reinauer/amiga_replacement_project/amiga/Commodore_A1000_Mainboard.gif

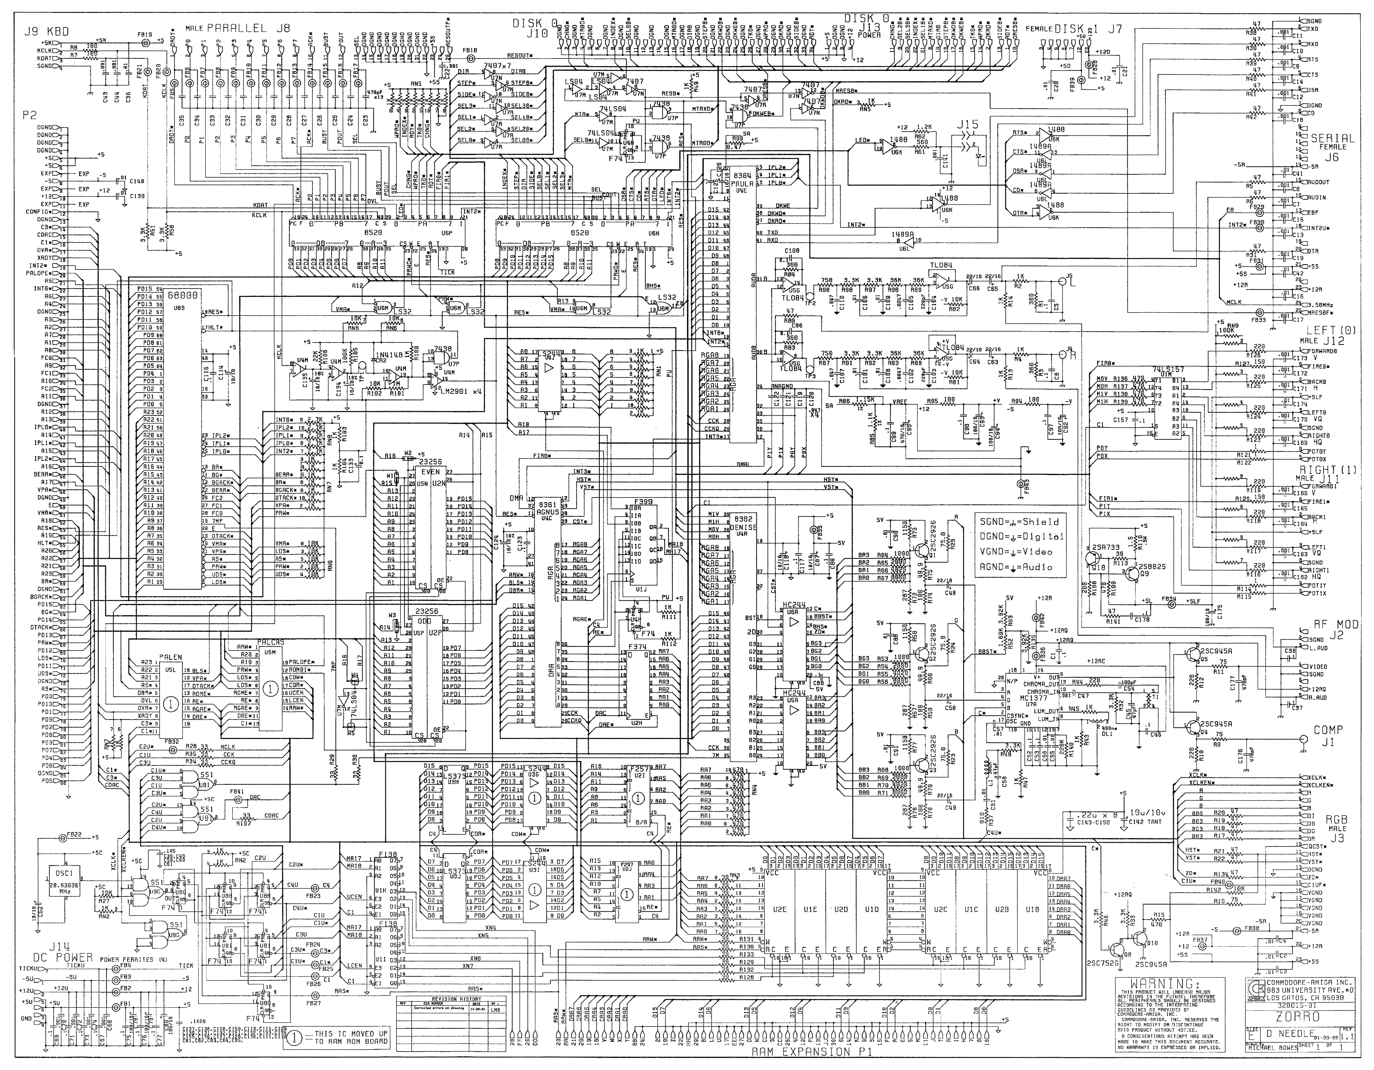
amiga/Commodore_A1000_Mainboard.gif
