reinauer/amiga_replacement_project/amiga/Commodore_A1000_RAM_ROM.gif

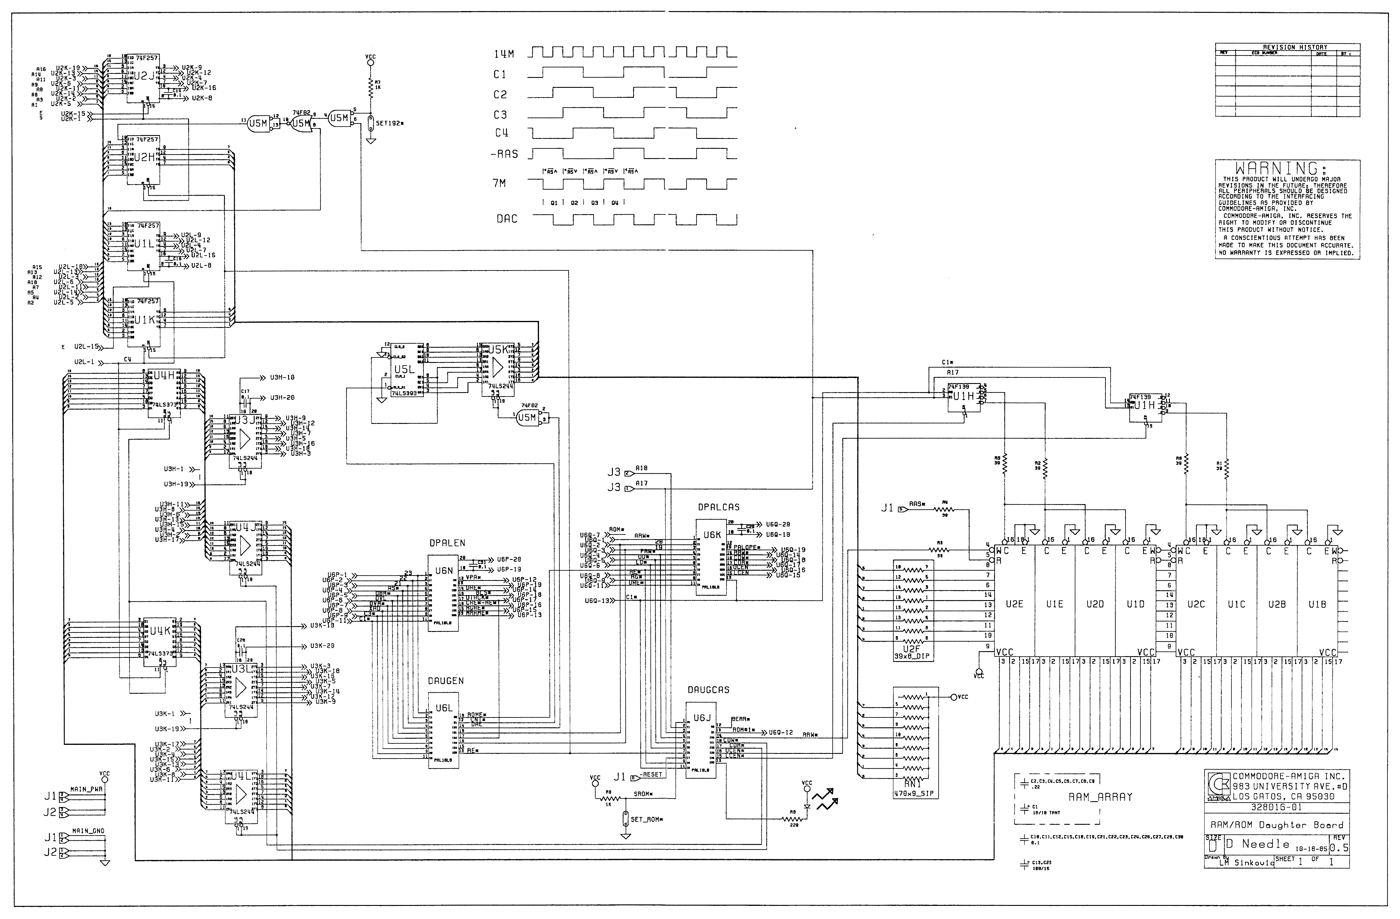
amiga/Commodore_A1000_RAM_ROM.gif
