reinauer/amiga_replacement_project/cia/MOS_8520r4_cia_schematic.png

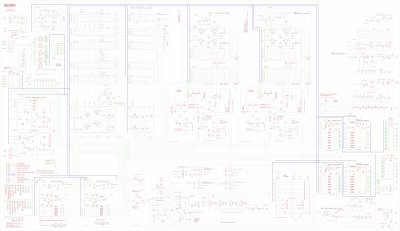
cia/MOS_8520r4_cia_schematic.png
