reinauer/amiga_replacement_project/denise/refs/bpl_shifters.jpg

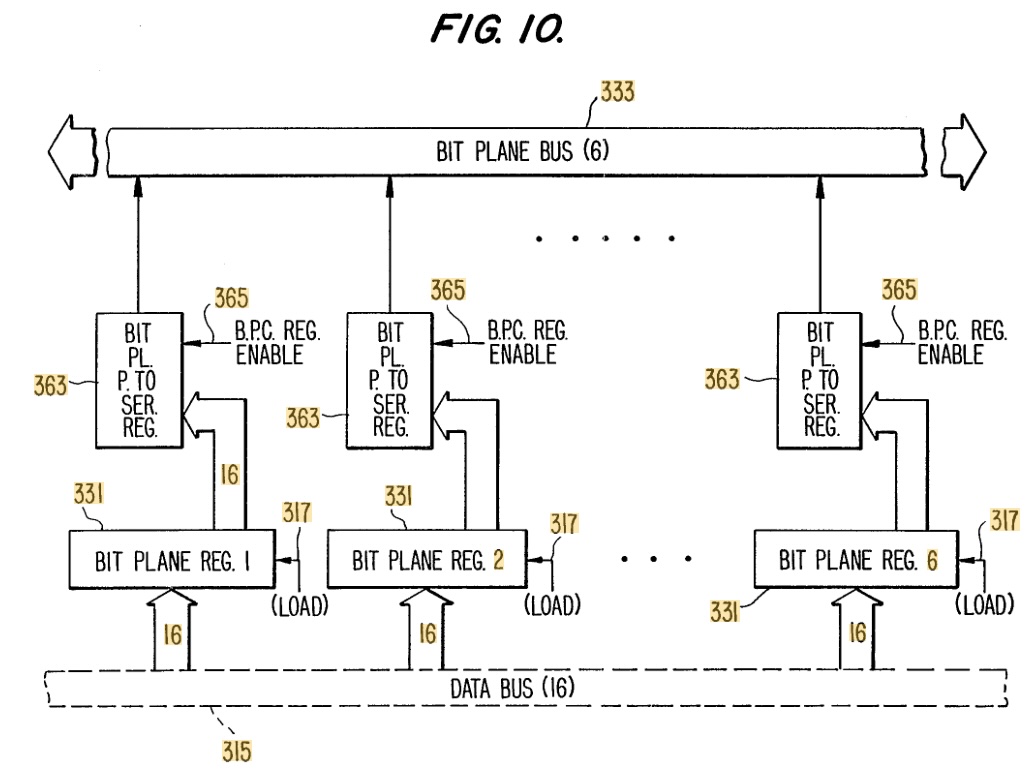
denise/refs/bpl_shifters.jpg
