reinauer/amiga_replacement_project/denise/refs/denise_block.png

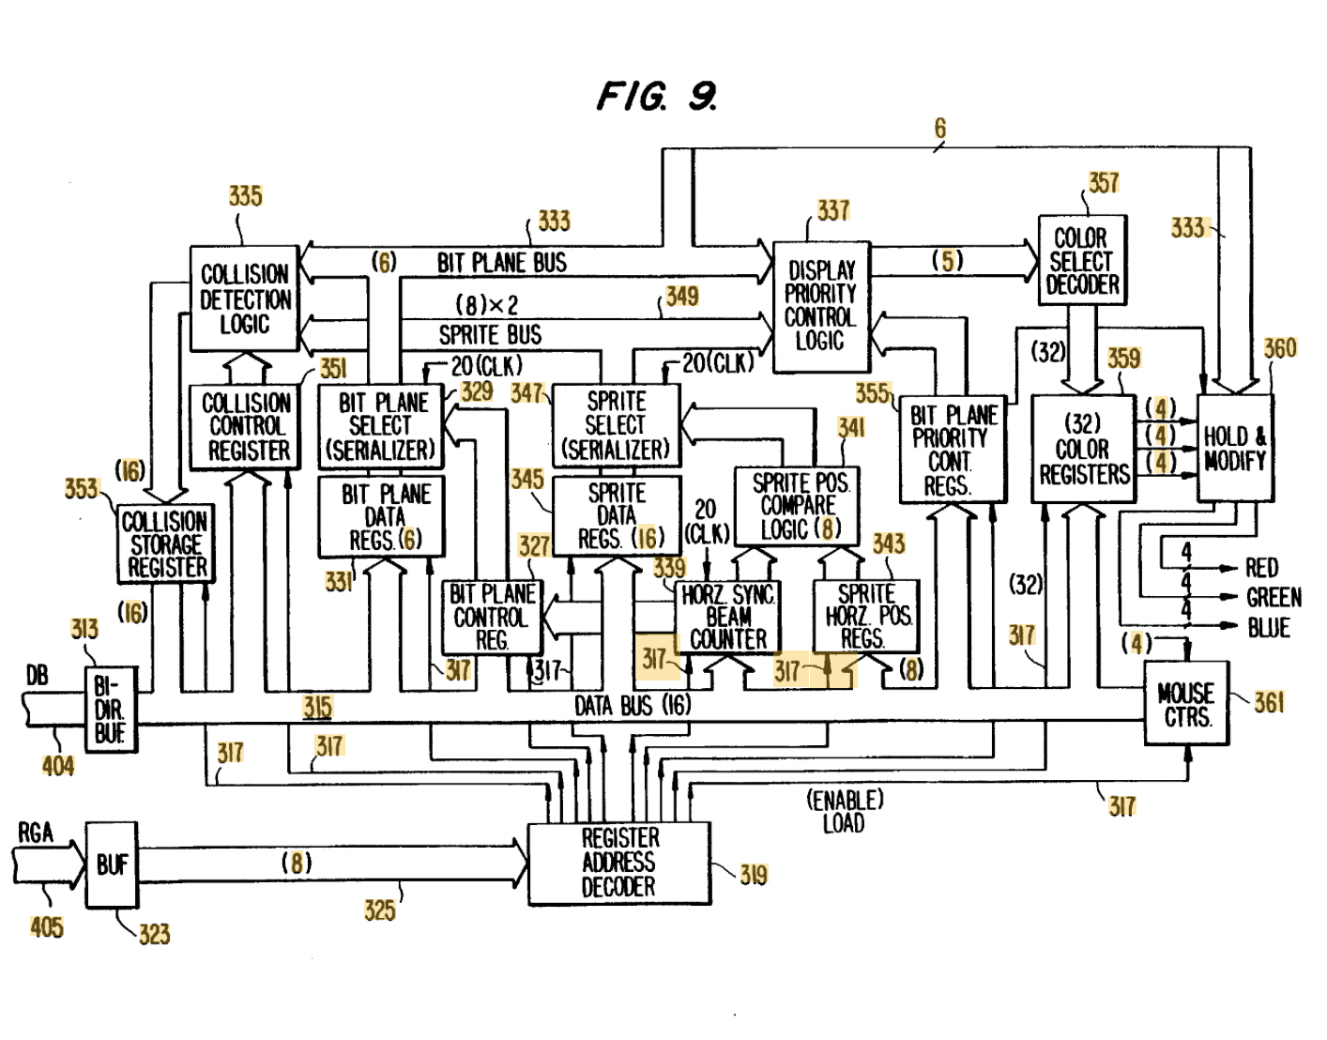
denise/refs/denise_block.png
