reinauer/amiga_replacement_project/denise/refs/spr_shifters.jpg

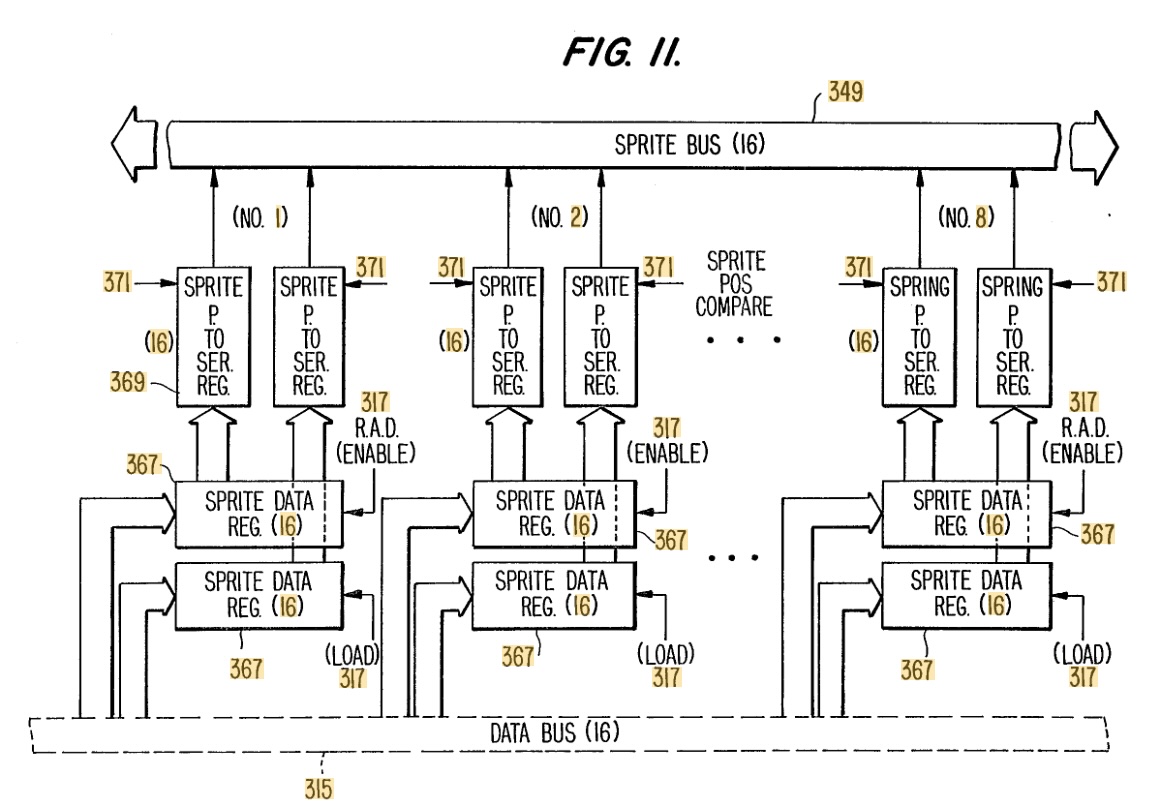
denise/refs/spr_shifters.jpg
