reinauer/amiga_replacement_project/gary/CSG_5719r4_gary_schematic.png

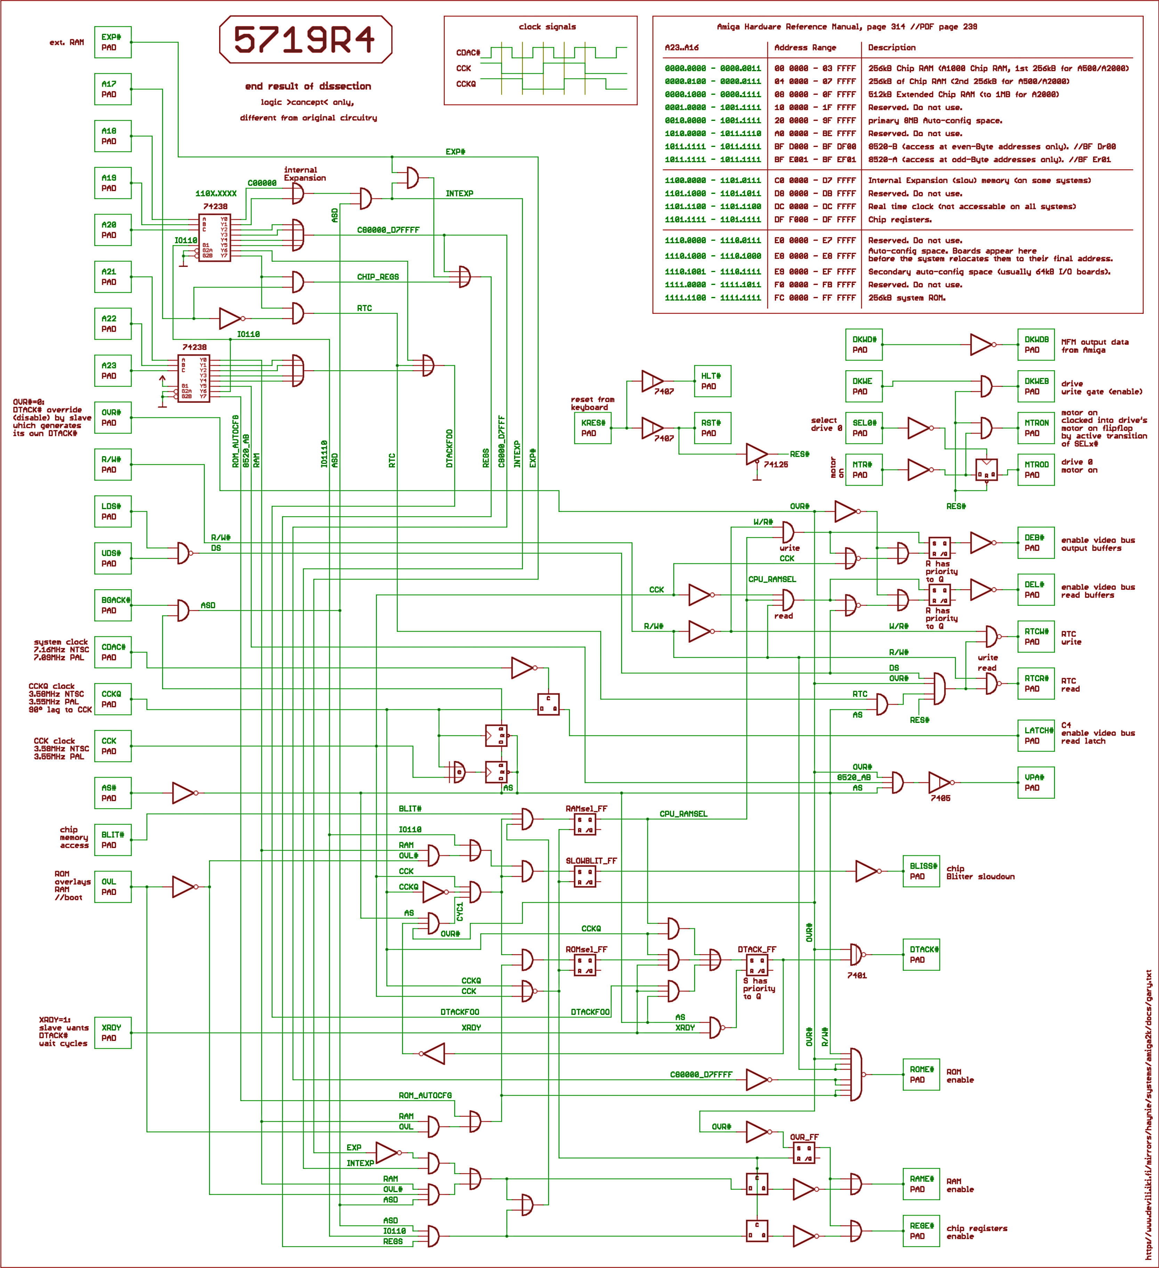
gary/CSG_5719r4_gary_schematic.png
