reinauer/amiga_replacement_project/amiga40dip/AmigaDIP40s.pdf

### BANK0

5V

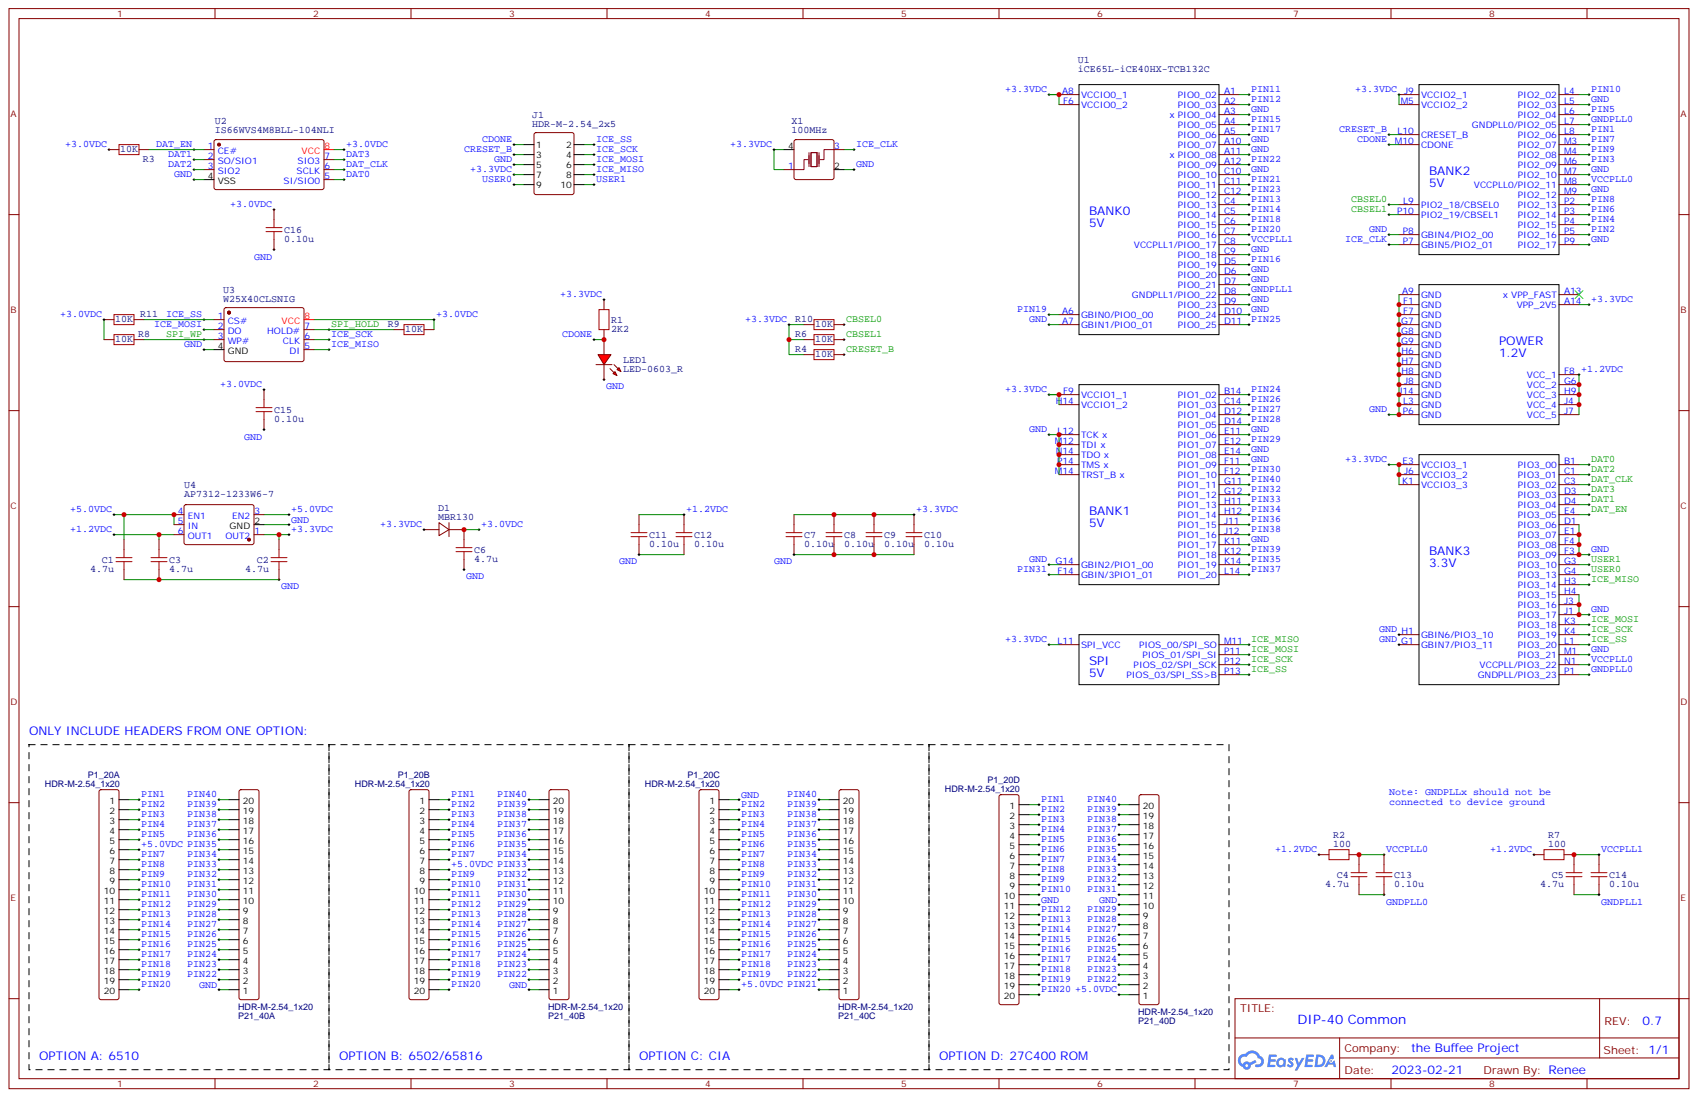
[picture p8: page 1]

ONLY INCLUDE HEADERS FROM ONE OPTION:

Note: GNDPLLx should not be
connected to device ground

Company: the Buffee Project
