reinauer/amiga_replacement_project/amiga48dip/AmigaDIP48s.pdf

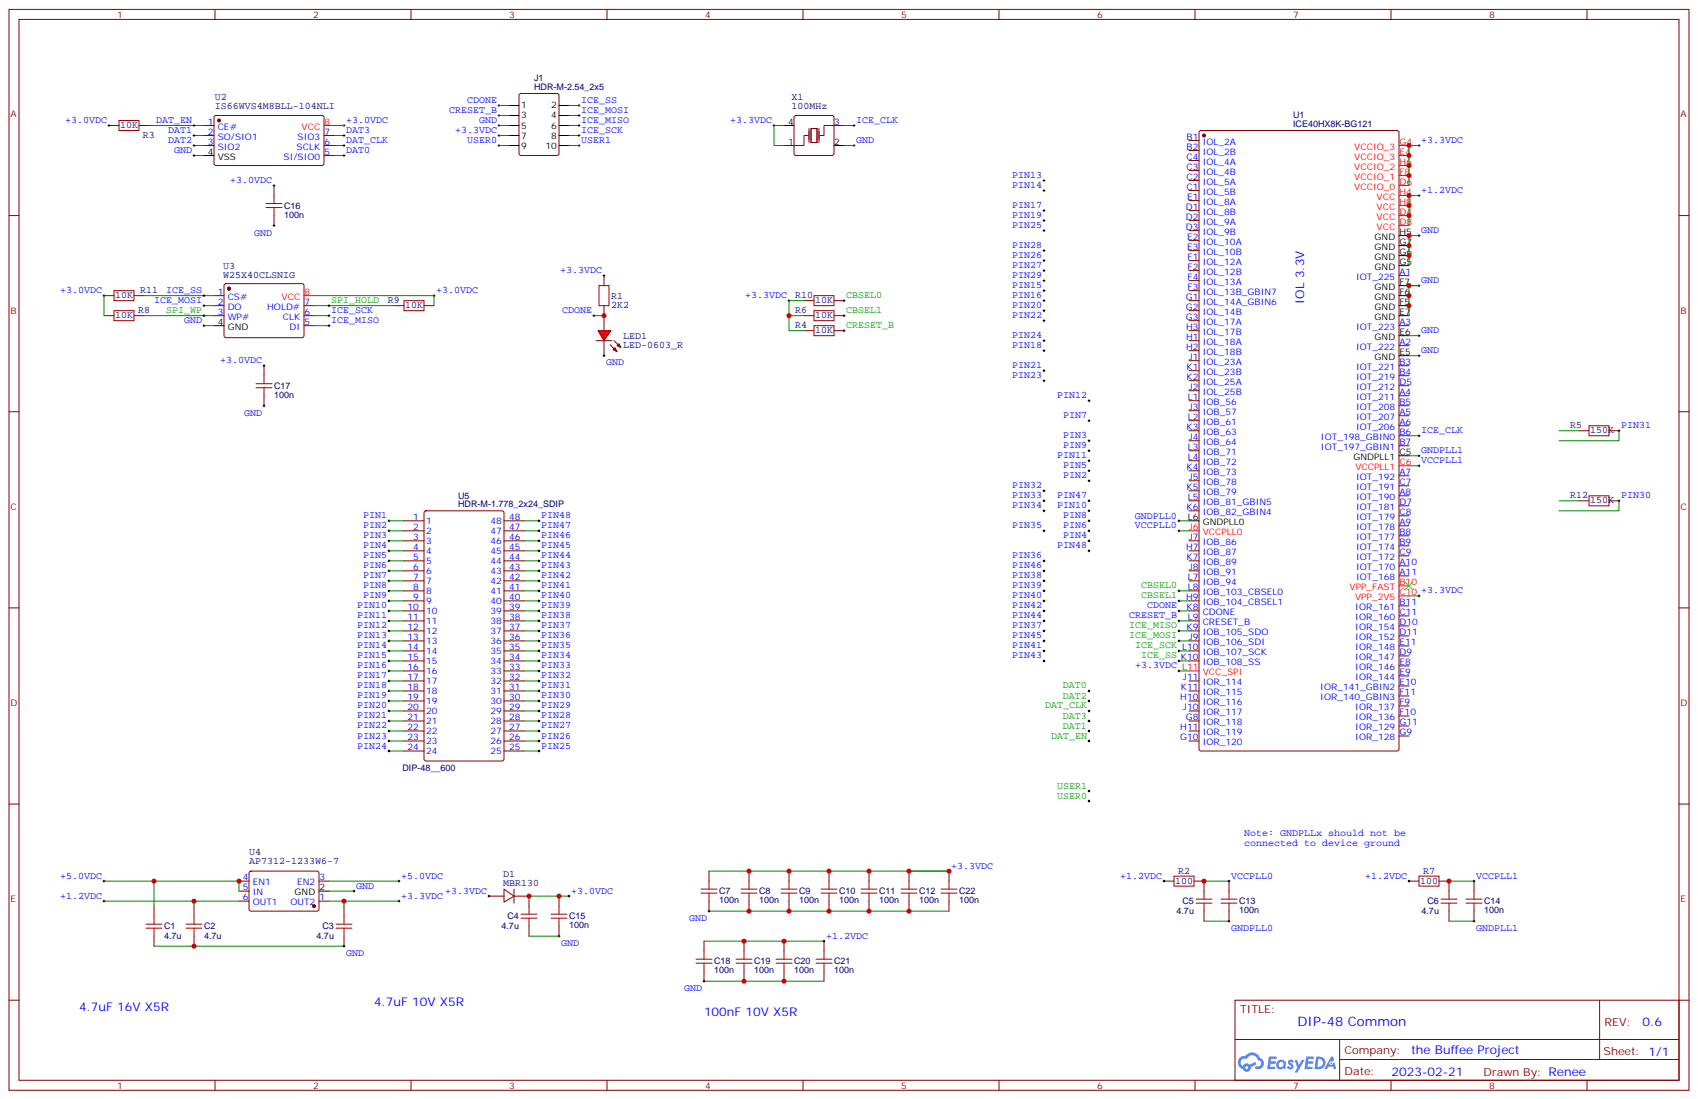
[picture p9: page 1]

Note: GNDPLLx should not be
connected to device ground

Company: the Buffee Project
