reinauer/amiga_replacement_project/gary/Schematic_Gary-Repalcement.sch_2025-07-20.pdf

A | A

1

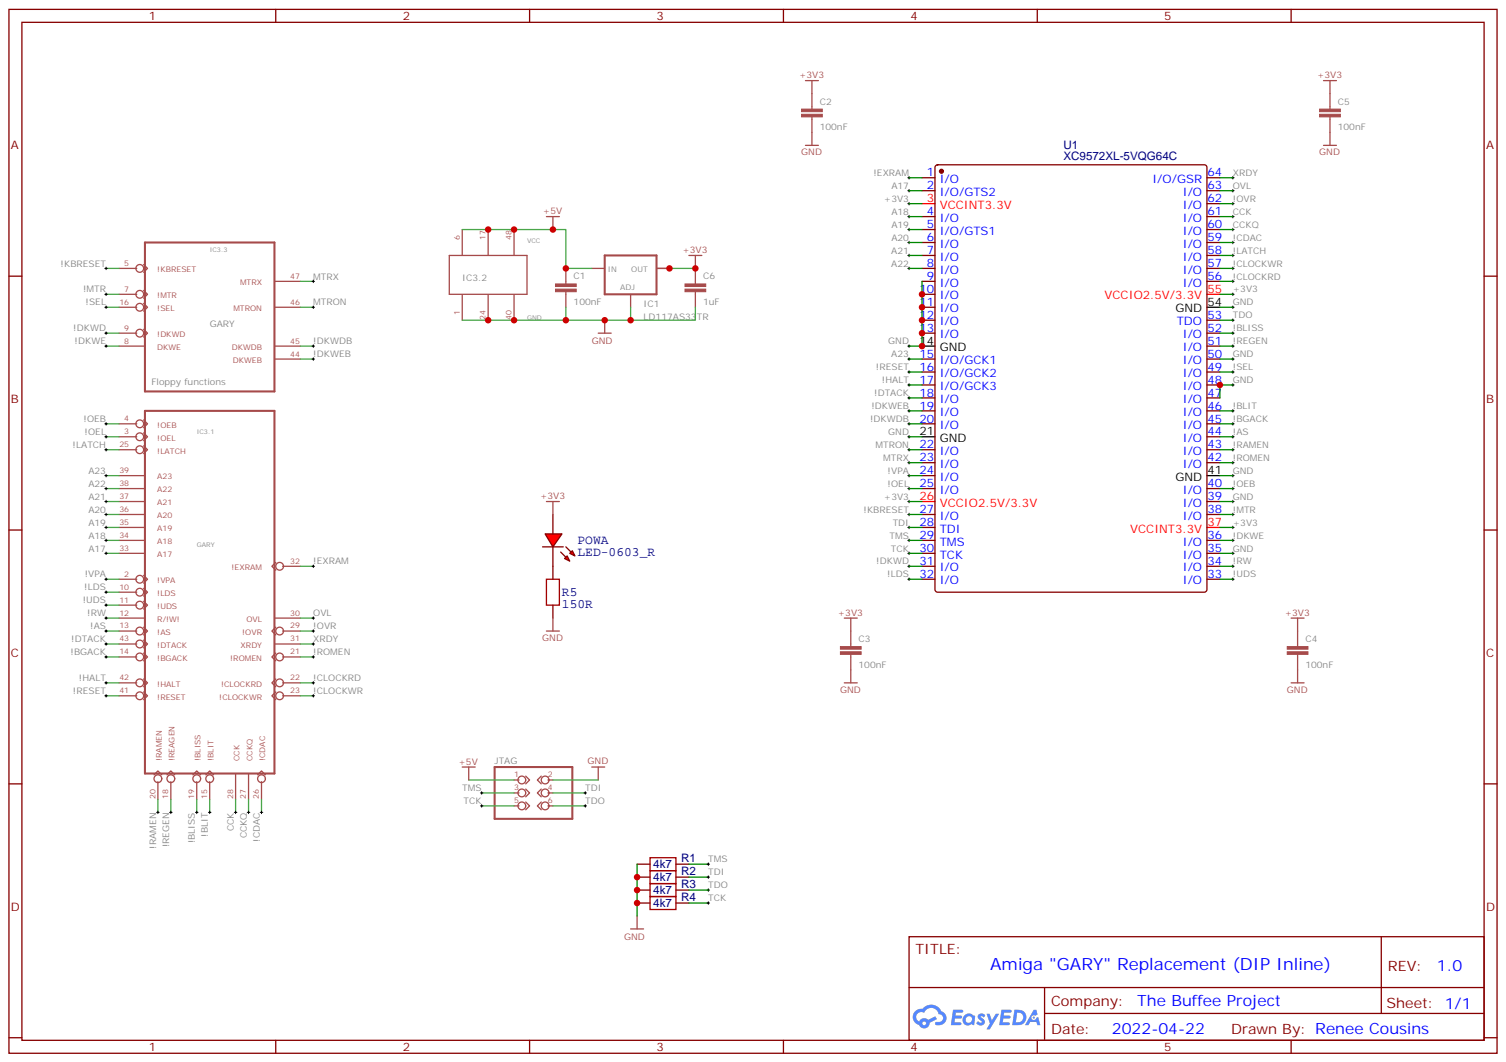
[picture p10: page 1]

Company: The Buffee Project

Drawn By: Renee Cousins
