reinauer/amiga_replacement_project/amber/amber-design-rev6-1.pdf

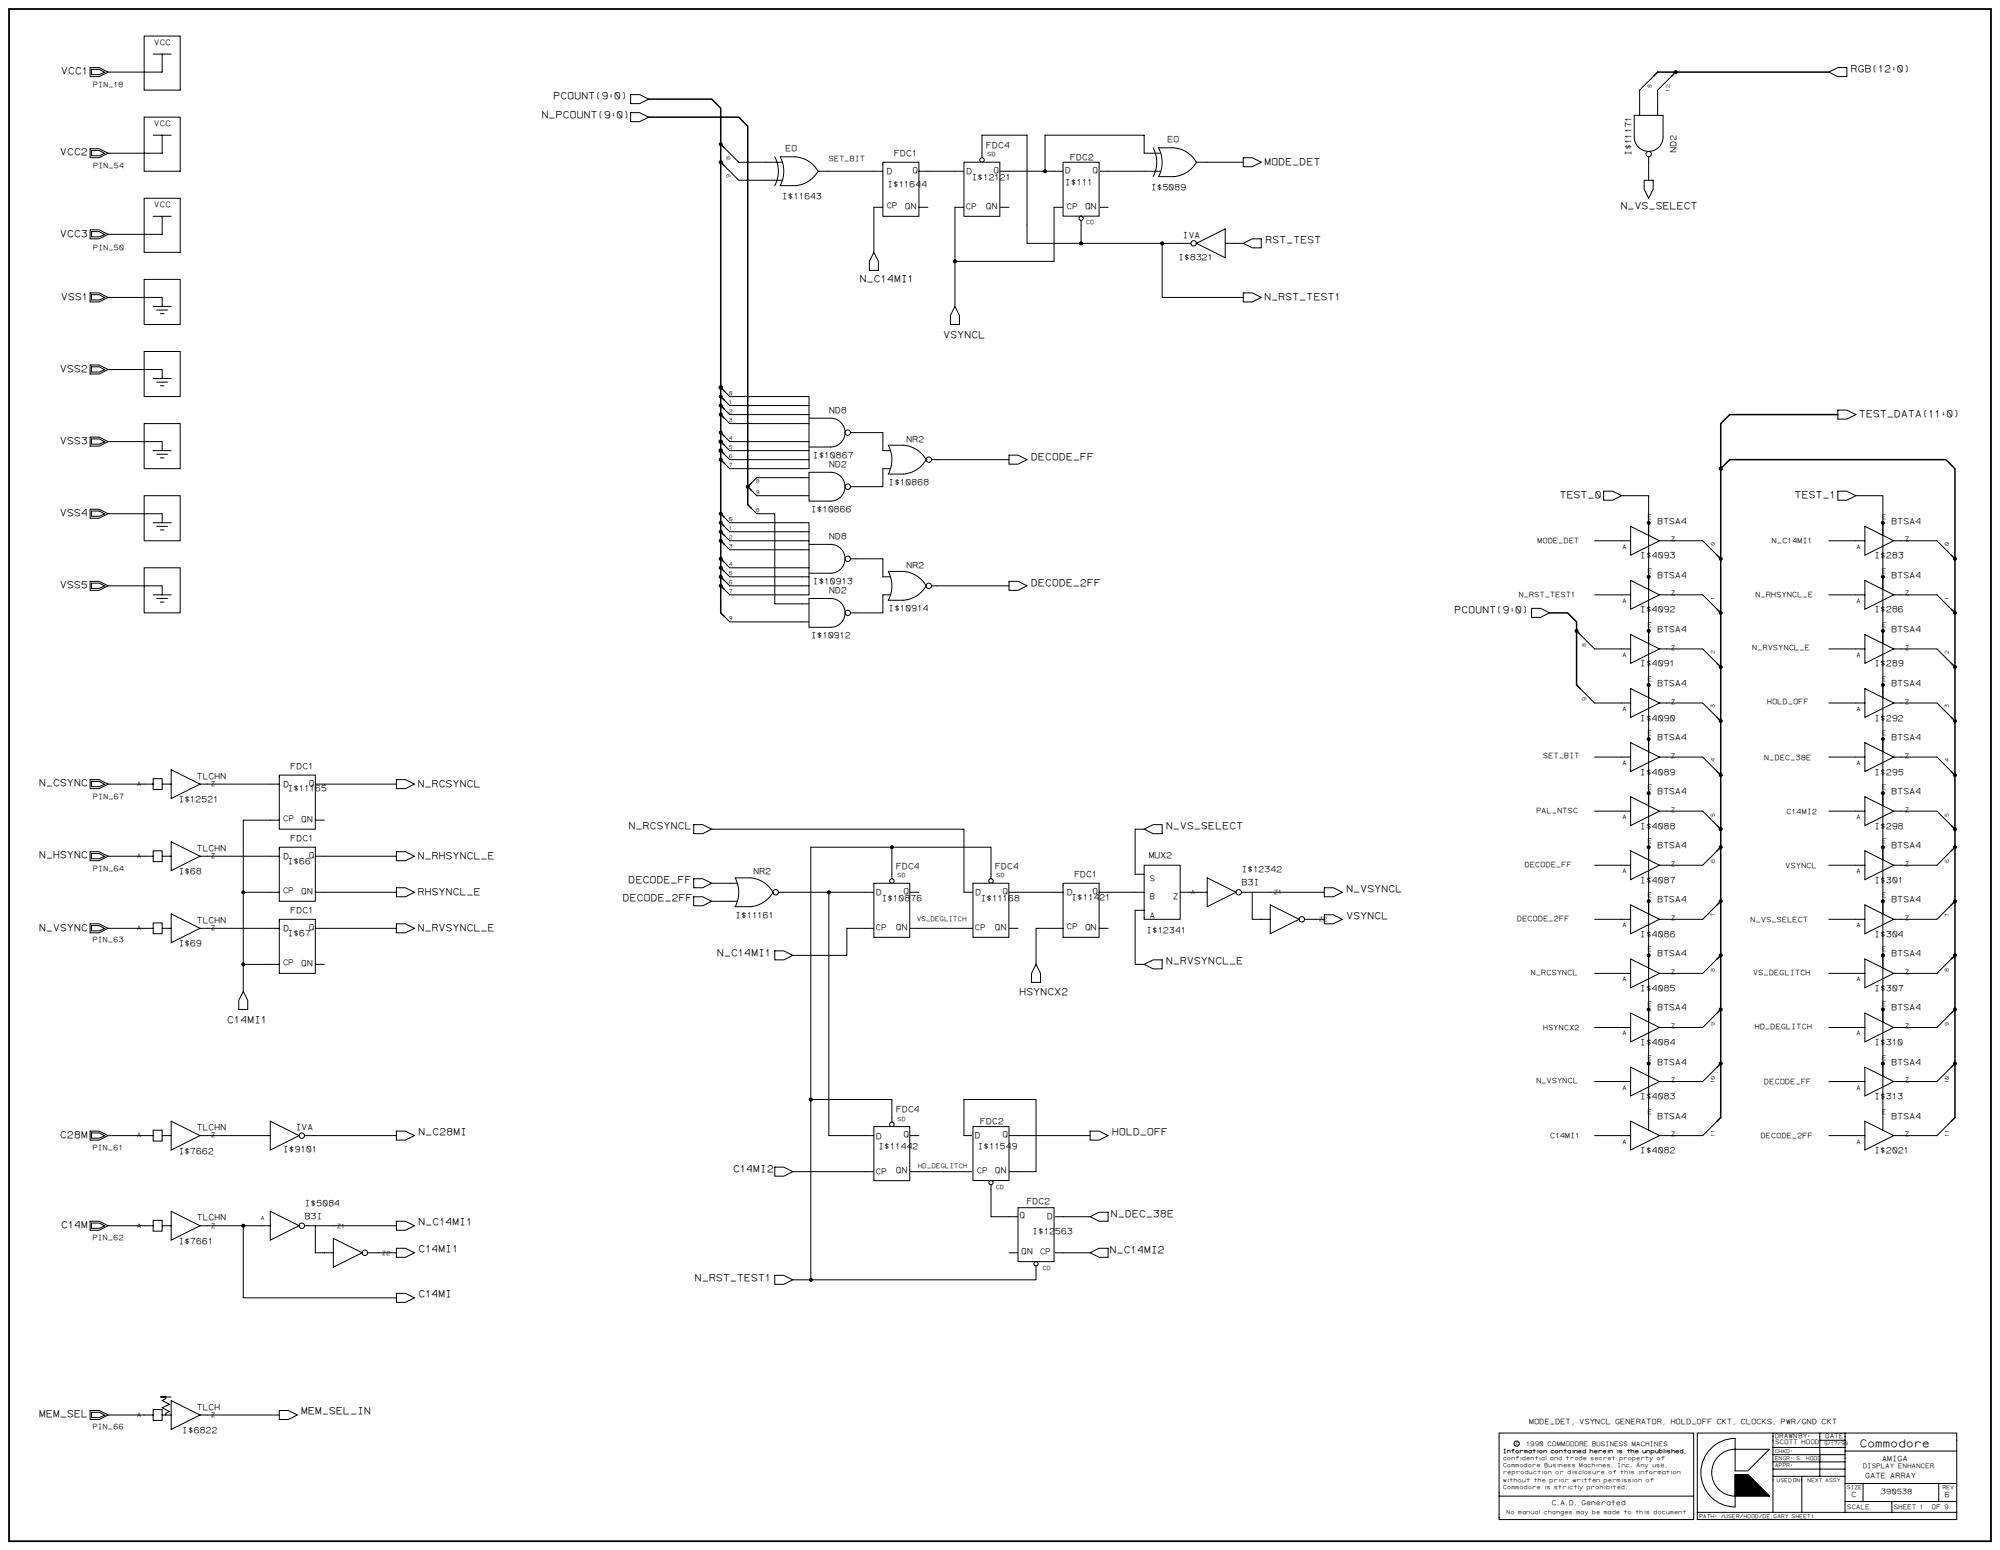
[picture p11: page 1]
N_VSYNC; PIN_63; N_HSYNC; PIN_64; TEST_0; PCOUNT(9:0); VSYNCL; RST_TEST; N_DEC_38E; MODE_DET; MEM_SEL; PIN_66; N_VS_SELECT; VS_DEGLITCH; HD_DEGLITCH; DECODE_FF; VSS2; DECODE_2FF; VSS4; PIN_62; VSS3; VSS5; TEST_DATA(11:0); N_RST_TEST1; MEM_SEL_IN; PIN_61; TEST_1; N_RCSYNCL; N_RVSYNCL_E; N_RHSYNCL_E; N_PCOUNT(9:0); SET_BIT; PAL_NTSC; PIN_67; N_CSYNC; N_VSYNCL; HSYNCX2; RGB(12:0); RHSYNCL_E; VCC3; PIN_50; HD_DEGLITCH C14MI2; VCC2; PIN_54; VSS1; VCC1; PIN_18; HOLD_OFF; Commodore; DRAWN BY:; DATE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

MODE_DET, VSYNCL GENERATOR, HOLD_OFF CKT, CLOCKS, PWR/GND CKT

1990 COMMODORE BUSINESS MACHINES

Information Information contained contained herein is the unpublished, unpublished,
confidential and trade secret property of
Commodore Business Machines, Inc. Any use,
reproduction or disclosure of this information
without the prior written permission of
Commodore is strictly prohibited.

CHKD:
ENGR: S. HOOD
APPR:

USED ON | NEXT ASSY

SIZE C 6 | 390538 | REV

SCALE | SHEET 1 OF 9

No manual changes may be made to this document

PATH: /USER/HOOD/DE.GARY SHEET1

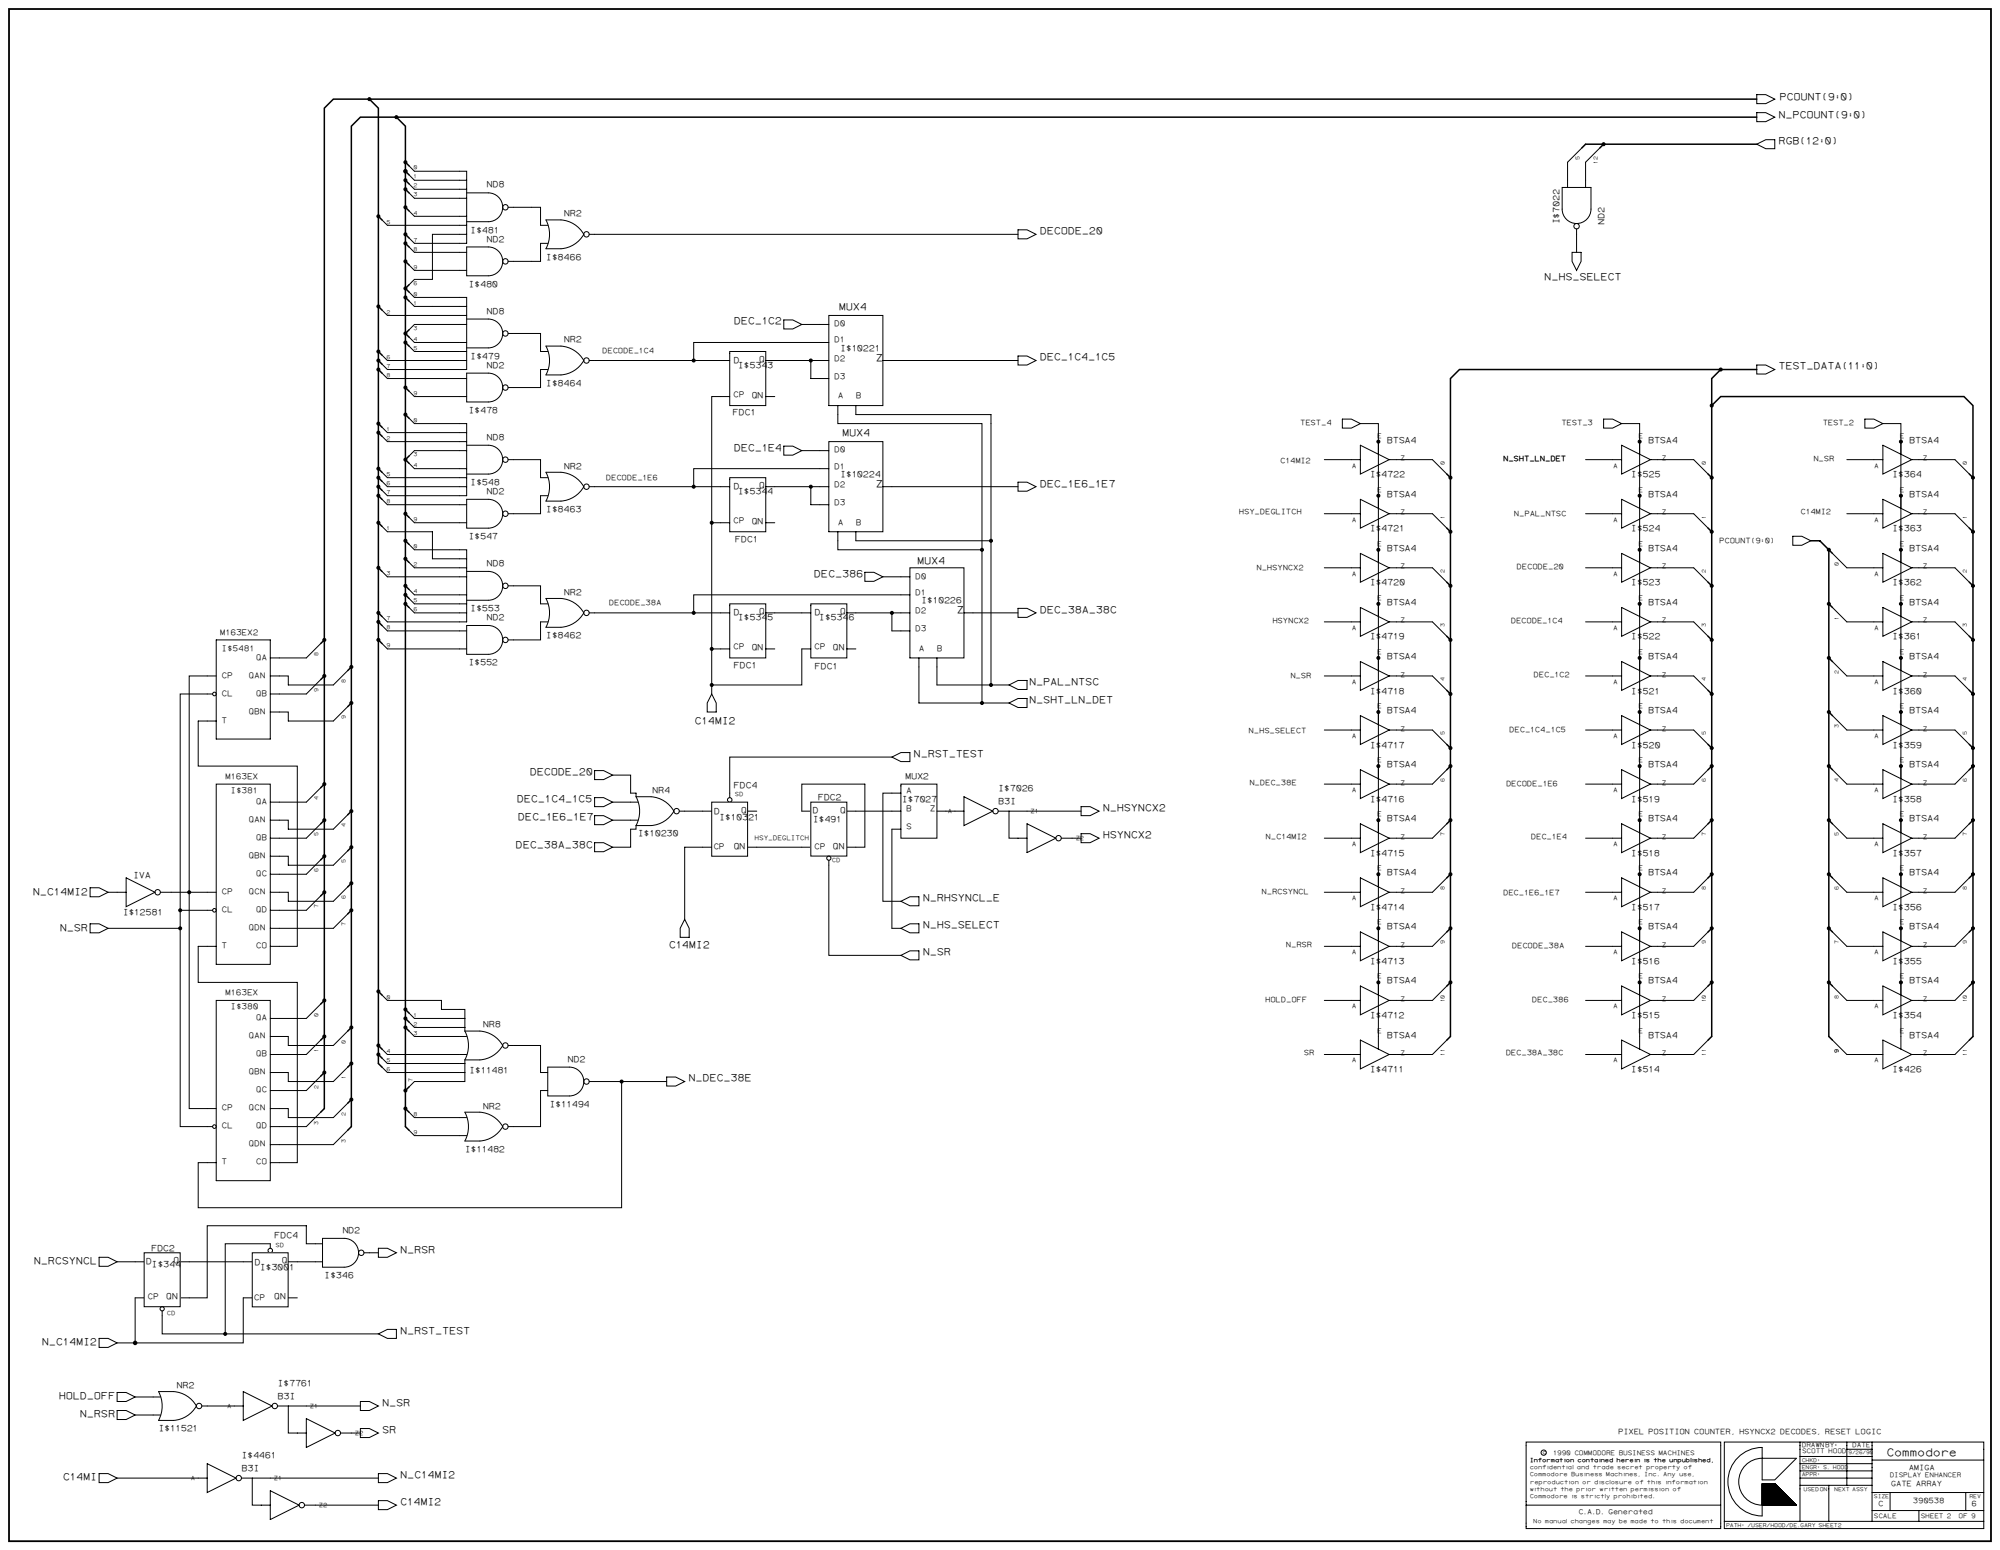
[picture p12: page 2]
N_RCSYNCL; N_RST_TEST; N_HS_SELECT; TEST_2; N_HSYNCX2; HSYNCX2; HOLD_OFF; N_RHSYNCL_E; TEST_4; TEST_3; TEST_DATA(11:0); N_RSR; N_SHT_LN_DET; HSY_DEGLITCH; RGB(12:0); DEC_38A_38C; DEC_1E6_1E7; DEC_1C4_1C5; DECODE_20; DECODE_1C4; DEC_1C2; DECODE_1E6; DEC_1E4; N_PAL_NTSC; DECODE_38A; DEC_386; PCOUNT(9:0); N_DEC_38E; SCALE; SHEET 2 OF 9; FDC2; MUX4; BTSA4; IVA; FDC4; MUX2; FDC1; QAN; QBN; QCN; QDN

PIXEL POSITION COUNTER, HSYNCX2 DECODES, RESET LOGIC

Information Information contained contained herein is the unpublished, unpublished,

PATH: /USER/HOOD/DE.GARY SHEET2

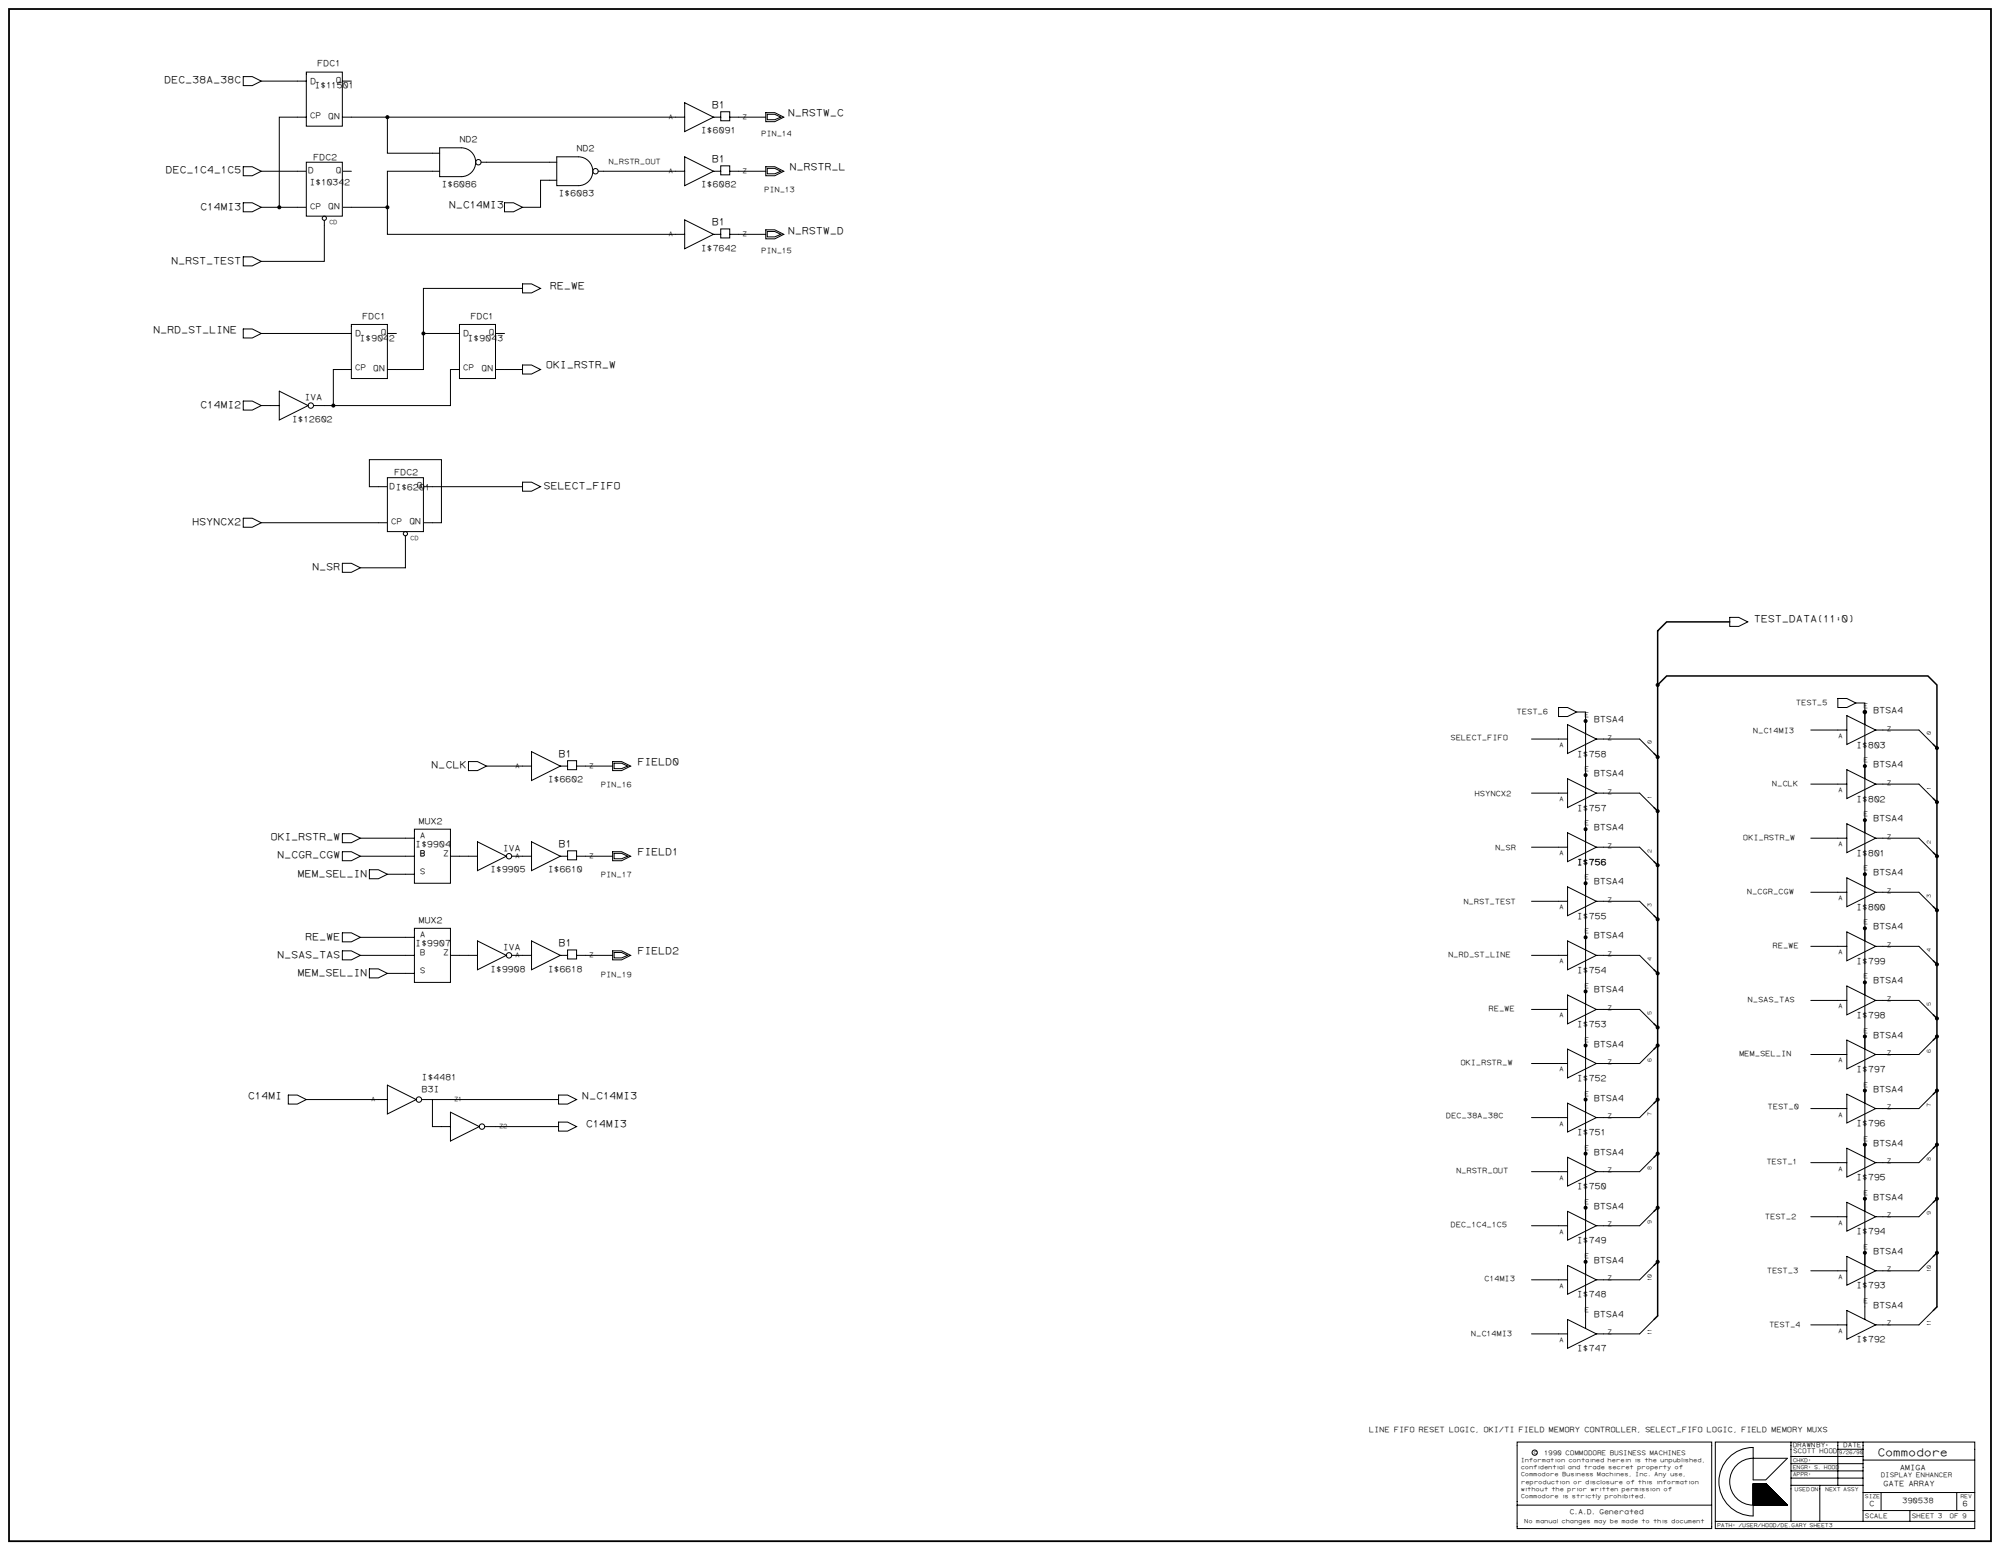
[picture p13: page 3]
HSYNCX2; N_RST_TEST; N_RD_ST_LINE; OKI_RSTR_W; TEST_5; TEST_6; MEM_SEL_IN; SELECT_FIFO; DEC_1C4_1C5; DEC_38A_38C; N_RSTR_OUT; N_CLK; N_RSTR_L; PIN_13; N_CGR_CGW; N_SAS_TAS; FIELD0; PIN_16; TEST_0; TEST_1; TEST_2; TEST_3; TEST_4; FIELD1; PIN_17; N_RSTW_C; PIN_14; N_RSTW_D; PIN_15; FIELD2; PIN_19; TEST_DATA(11:0); SCALE; SHEET 3 OF 9; IVA; MUX2; BTSA4; FDC2; FDC1

LINE FIFO RESET LOGIC, OKI/TI FIELD MEMORY CONTROLLER, SELECT_FIFO LOGIC, FIELD MEMORY MUXS

Information contained herein is the unpublished,

PATH: /USER/HOOD/DE.GARY SHEET3

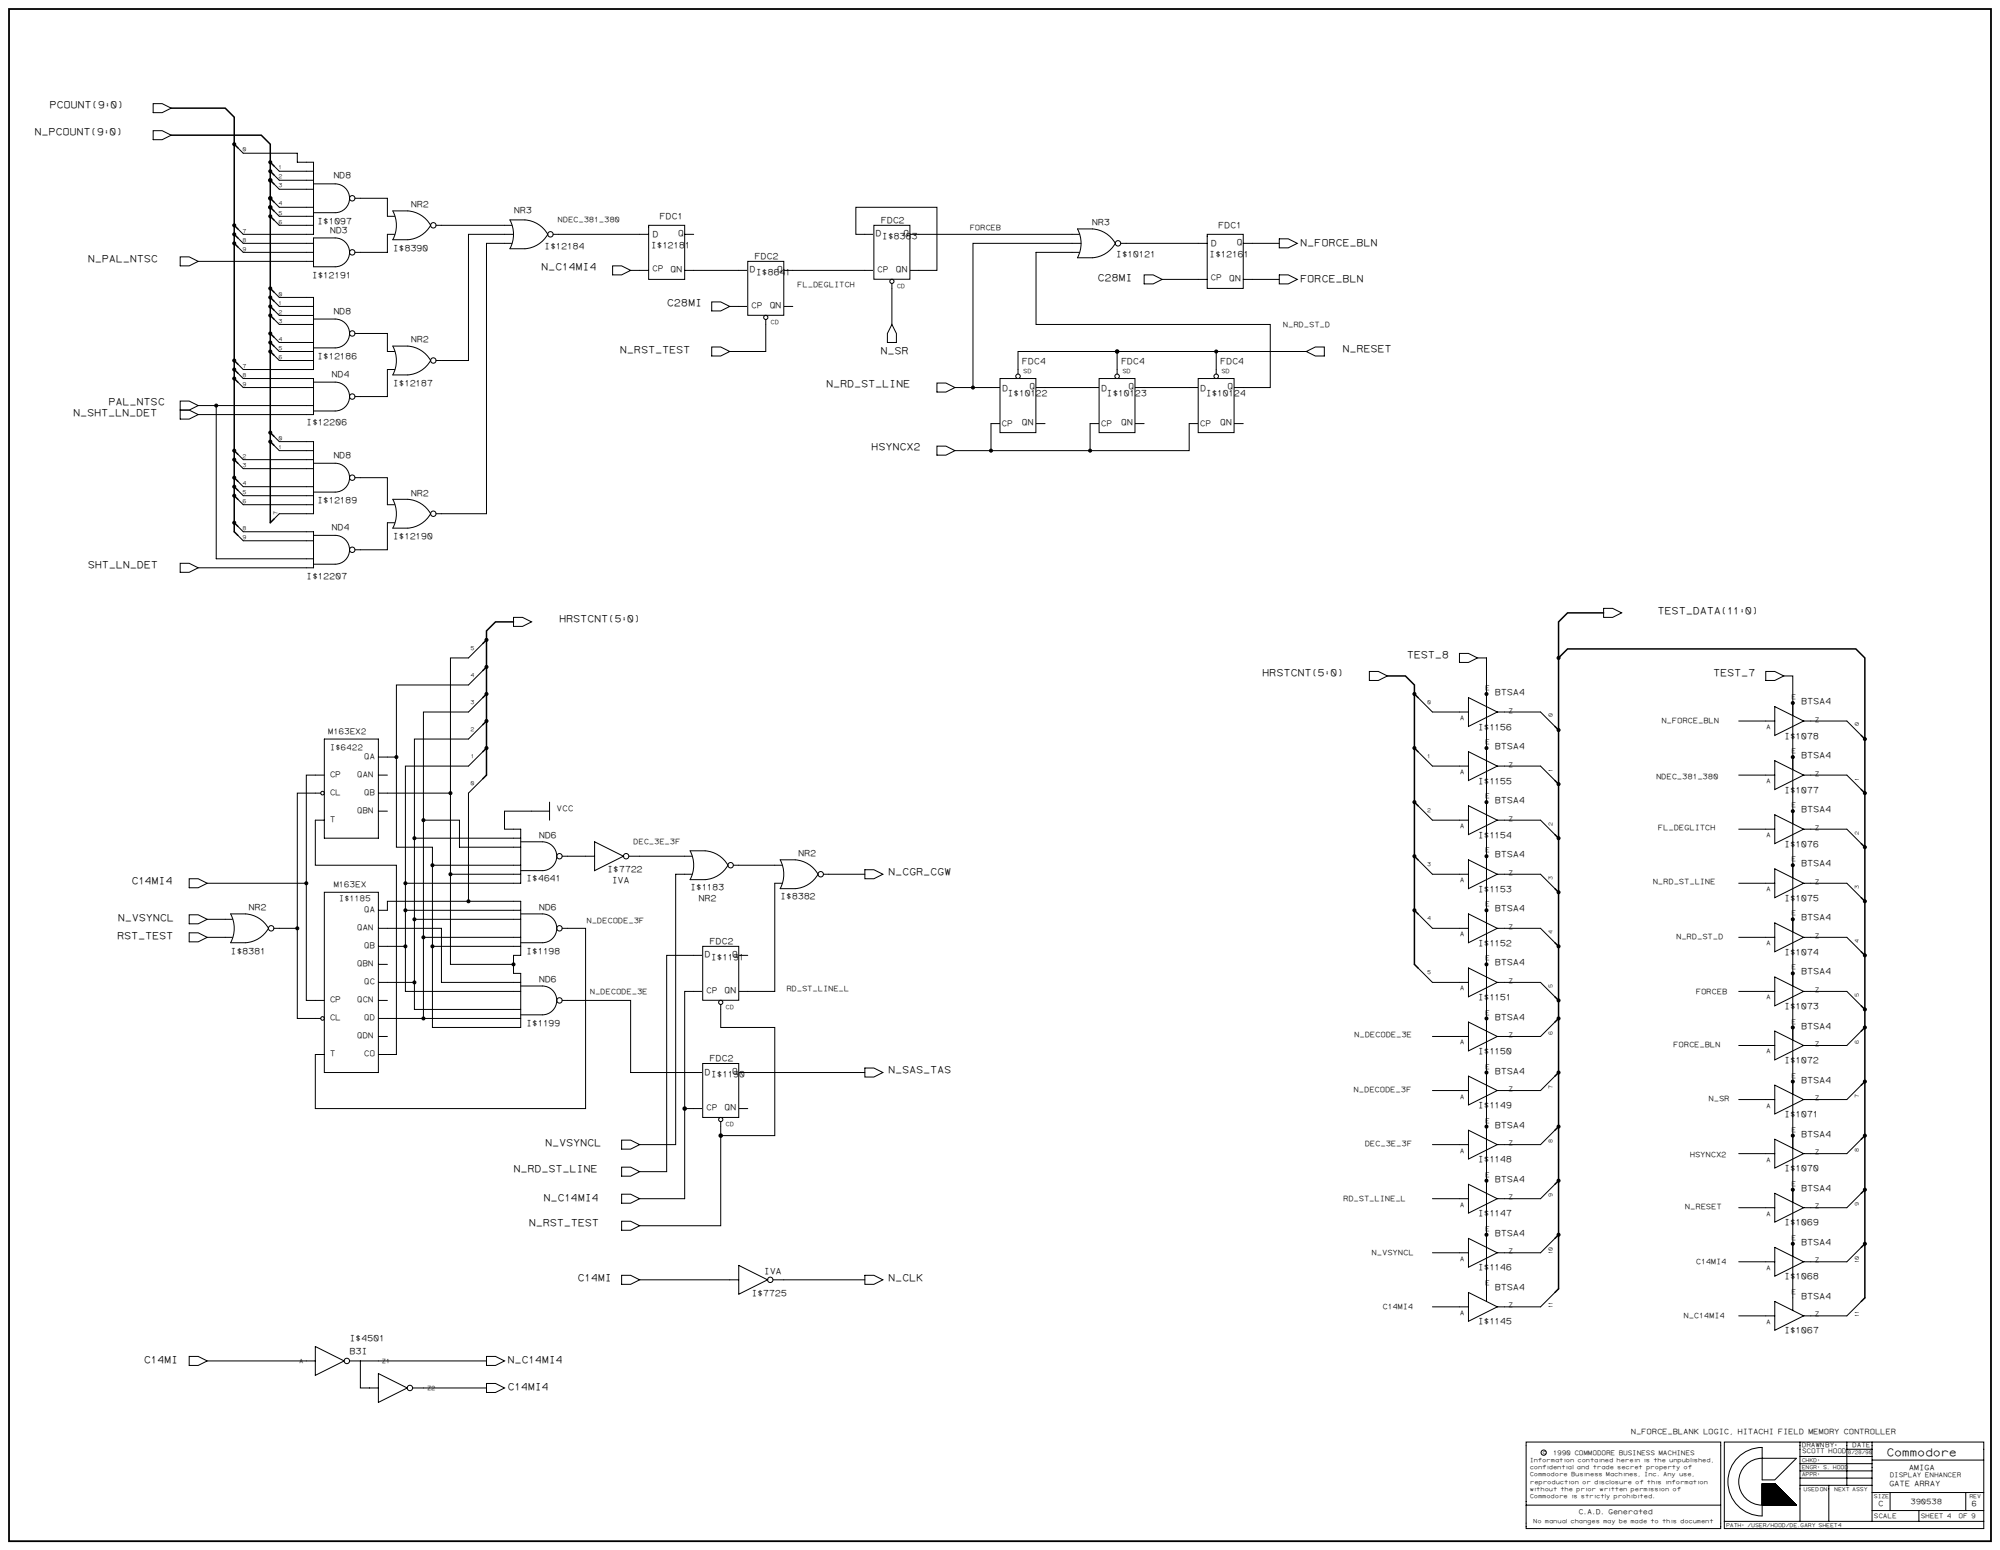
[picture p14: page 4]
RD_ST_LINE_L; N_CLK; N_DECODE_3F; N_DECODE_3E; TEST_7; FORCE_BLN; FL_DEGLITCH; HSYNCX2; N_FORCE_BLN; N_RD_ST_LINE; N_RESET; NDEC_381_380; N_RST_TEST; TEST_8; N_SAS_TAS; N_CGR_CGW; FORCEB; DEC_3E_3F; N_PAL_NTSC; PAL_NTSC N_SHT_LN_DET; SHT_LN_DET; TEST_DATA(11:0); HRSTCNT(5:0); N_VSYNCL; RST_TEST; FDC1; I$7722 IVA; BTSA4; FDC4; SCALE; SHEET 4 OF 9; FDC2; VCC; IVA; QAN; QBN; QCN; QDN

N_FORCE_BLANK LOGIC, HITACHI FIELD MEMORY CONTROLLER

PATH: /USER/HOOD/DE.GARY SHEET4

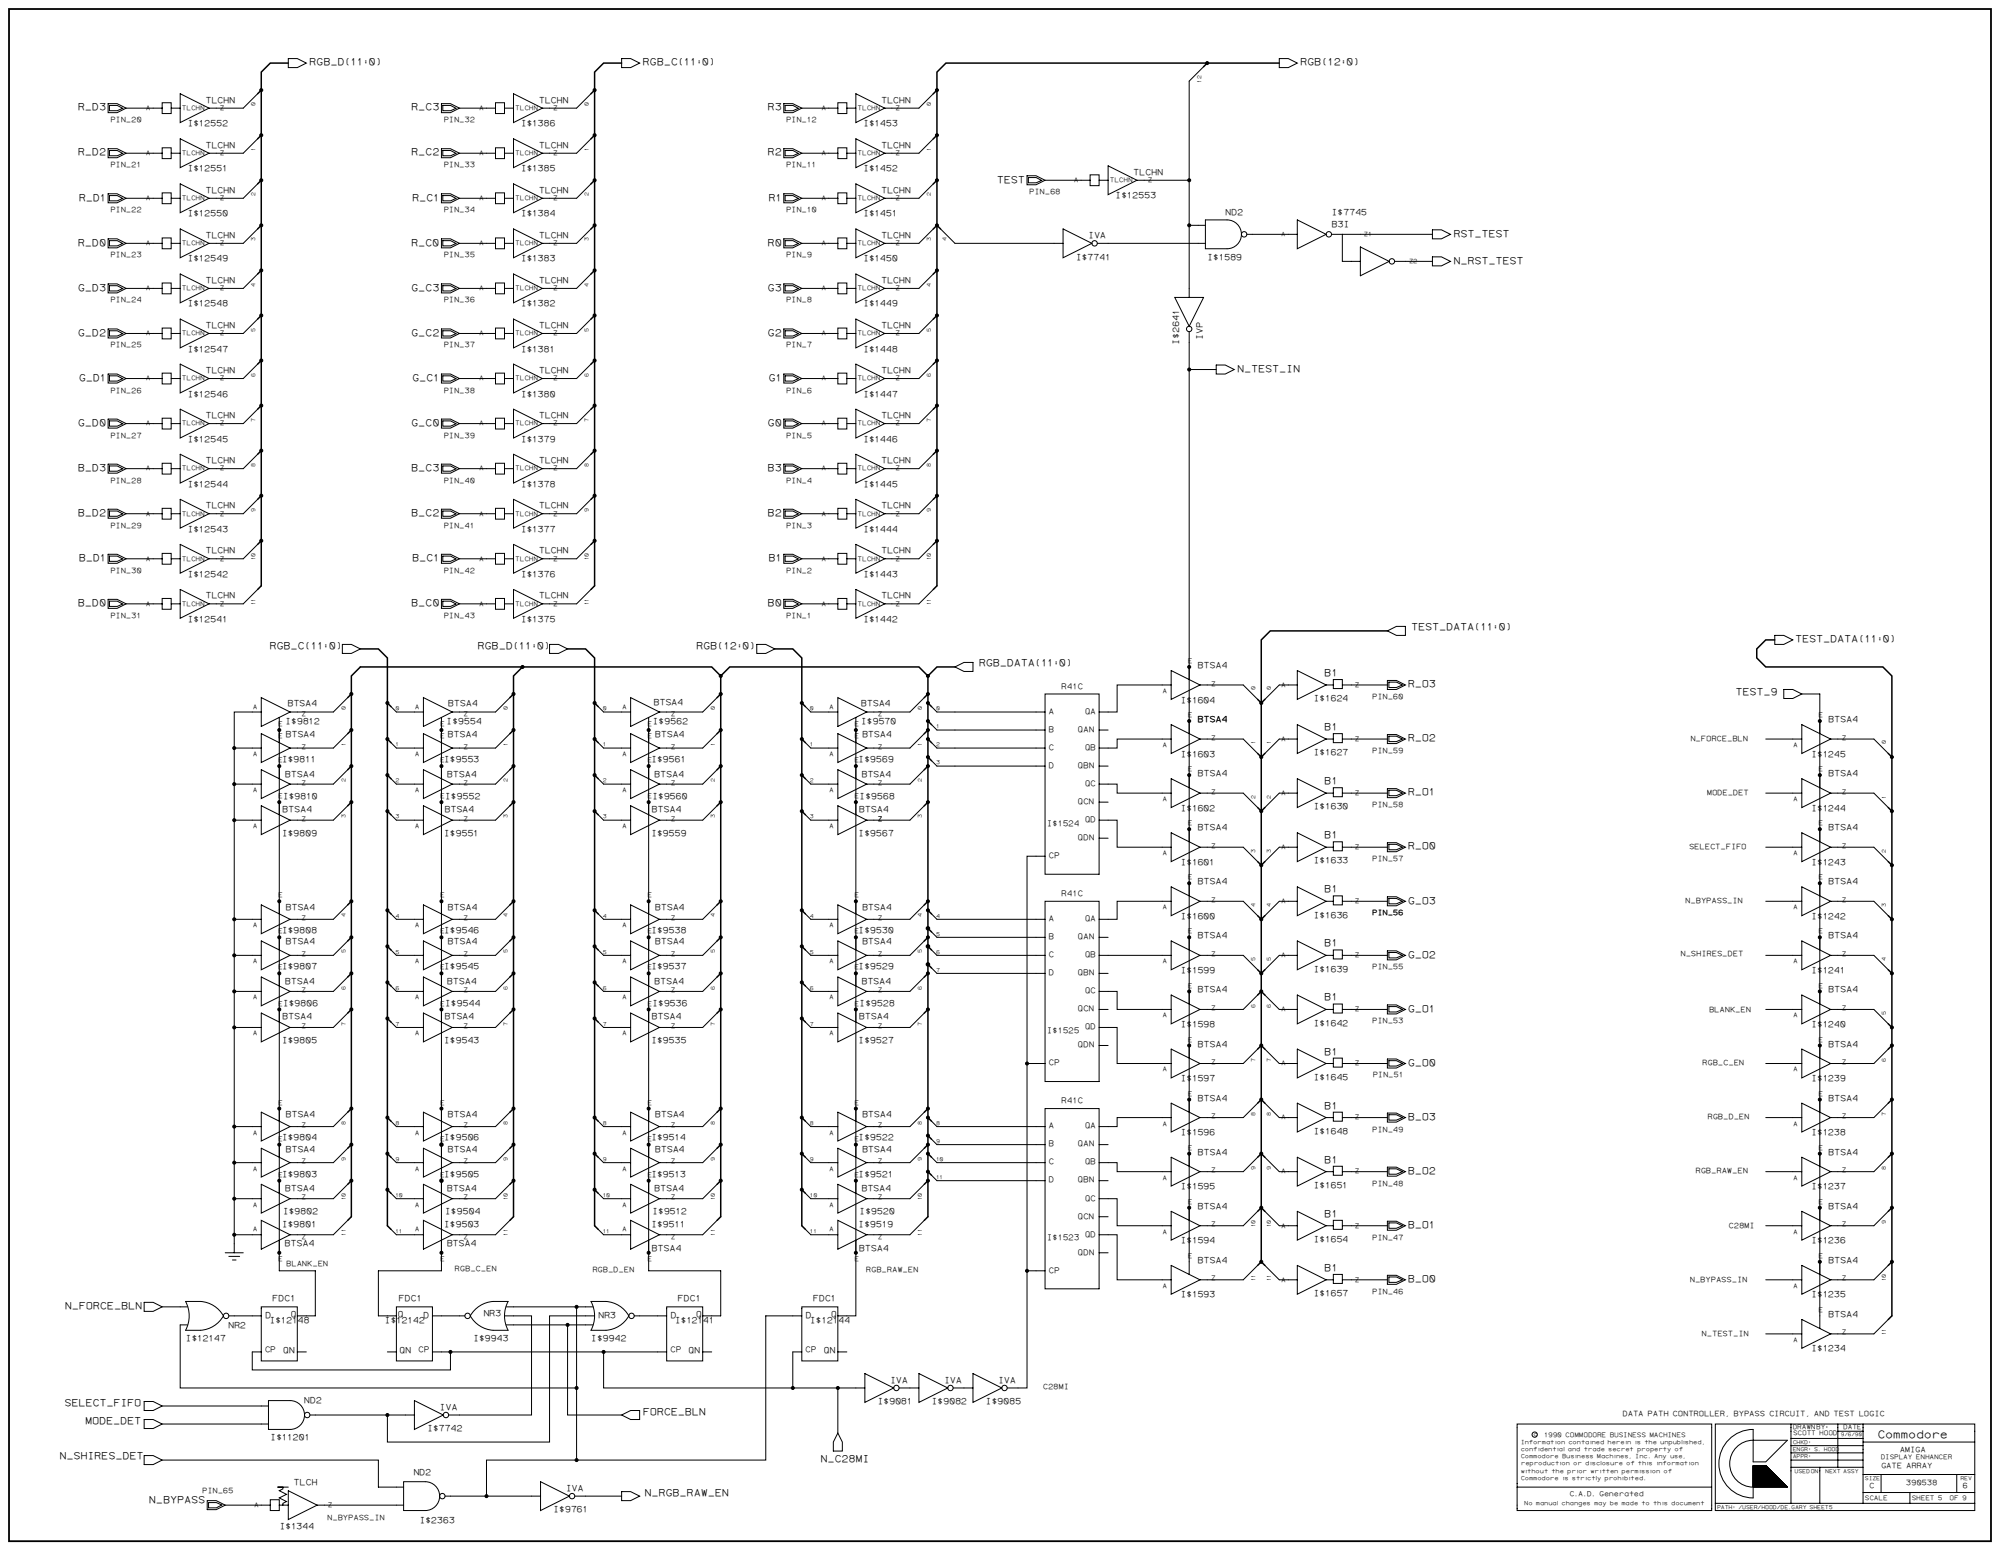
[picture p15: page 5]
PIN_20; PIN_21; TEST_9; PIN_22; PIN_23; N_SHIRES_DET; PIN_24; PIN_25; PIN_26; PIN_27; PIN_28; PIN_29; PIN_30; PIN_31; N_BYPASS; PIN_65; SELECT_FIFO; N_BYPASS_IN; N_FORCE_BLN; BLANK_EN; RGB_RAW_EN; RGB_C_EN; MODE_DET; N_TEST_IN; TEST; PIN_68; RGB_D_EN; RGB_D(11:0); PIN_43; PIN_42; PIN_41; PIN_40; PIN_39; PIN_38; PIN_37; PIN_36; N_RST_TEST; PIN_35; RST_TEST; PIN_34; PIN_33; PIN_32; RGB_C(11:0); FORCE_BLN; TEST_DATA(11:0); PIN_12; PIN_11; PIN_10; PIN_9; PIN_8; PIN_7; PIN_6; PIN_5; PIN_4; PIN_3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

DATA PATH CONTROLLER, BYPASS CIRCUIT, AND TEST LOGIC

PATH: /USER/HOOD/DE.GARY SHEET5

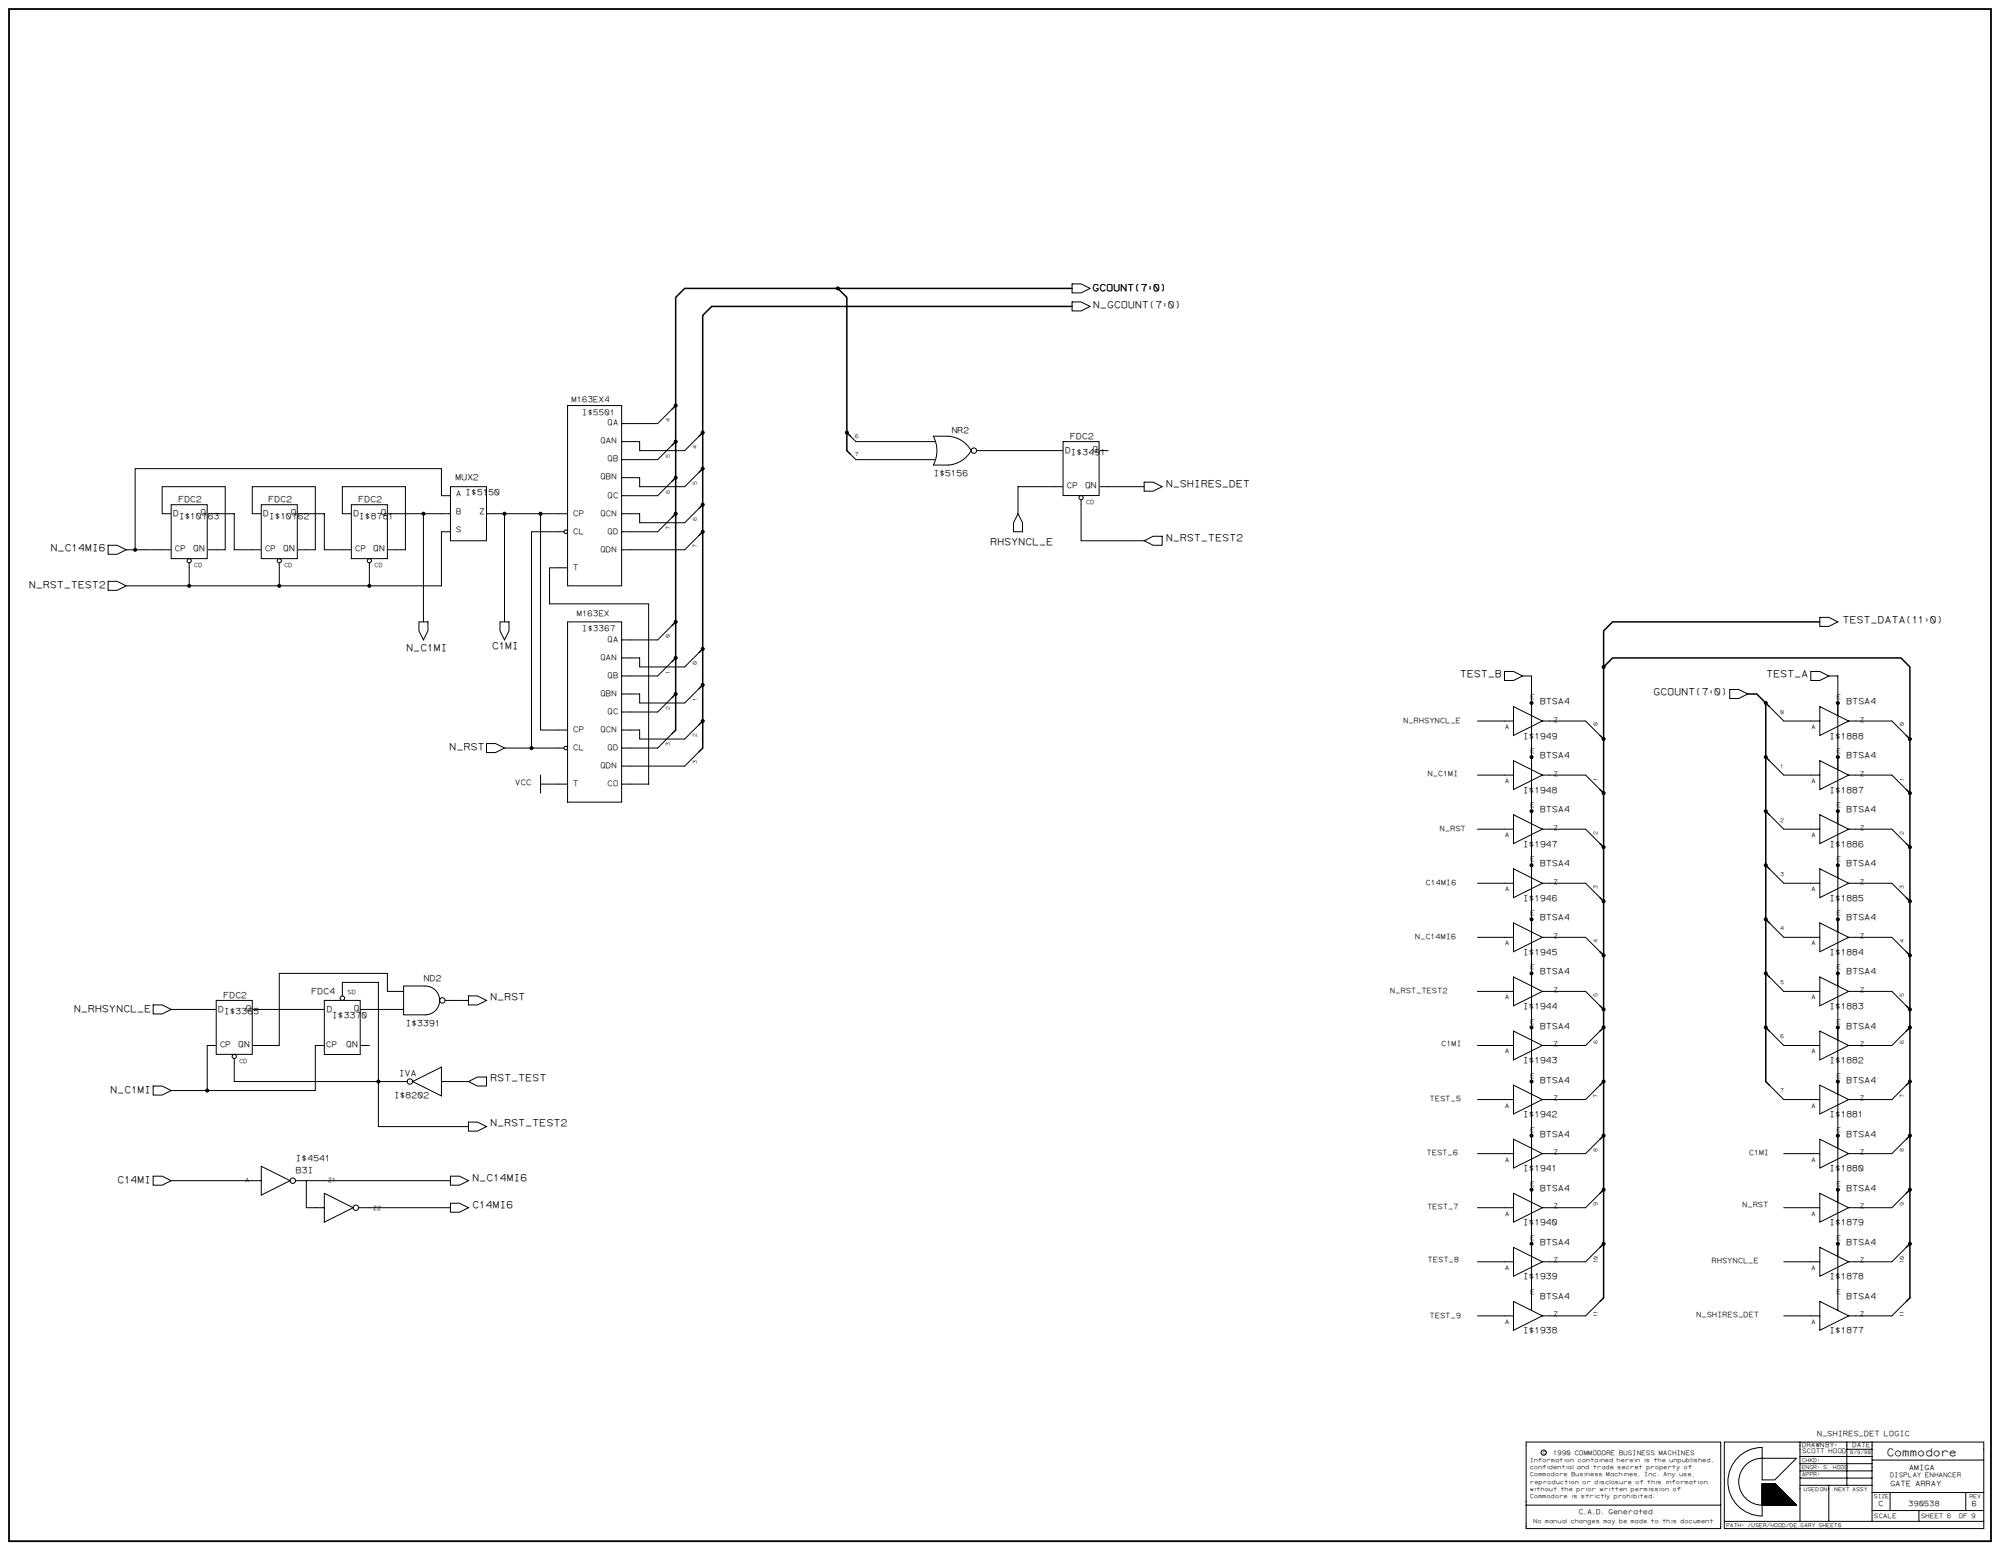
[picture p16: page 6]
TEST_B; RST_TEST; N_RST_TEST2; TEST_8; TEST_A; TEST_9; TEST_7; N_RST; N_RHSYNCL_E; GCOUNT(7:0); N_GCOUNT(7:0); TEST_6; TEST_5; N_SHIRES_DET; RHSYNCL_E; TEST_DATA(11:0); N_RST_TEST2 RHSYNCL_E; IVA; N_SHIRES_DET LOGIC; FDC2; MUX2; VCC; FDC4; BTSA4; QDN; QCN; QBN; QAN; CLT

Commodore is strictly prohibited. c

SCALE | SHEET 6 OF 9

PATH: /USER/HOOD/DE.GARY SHEET6

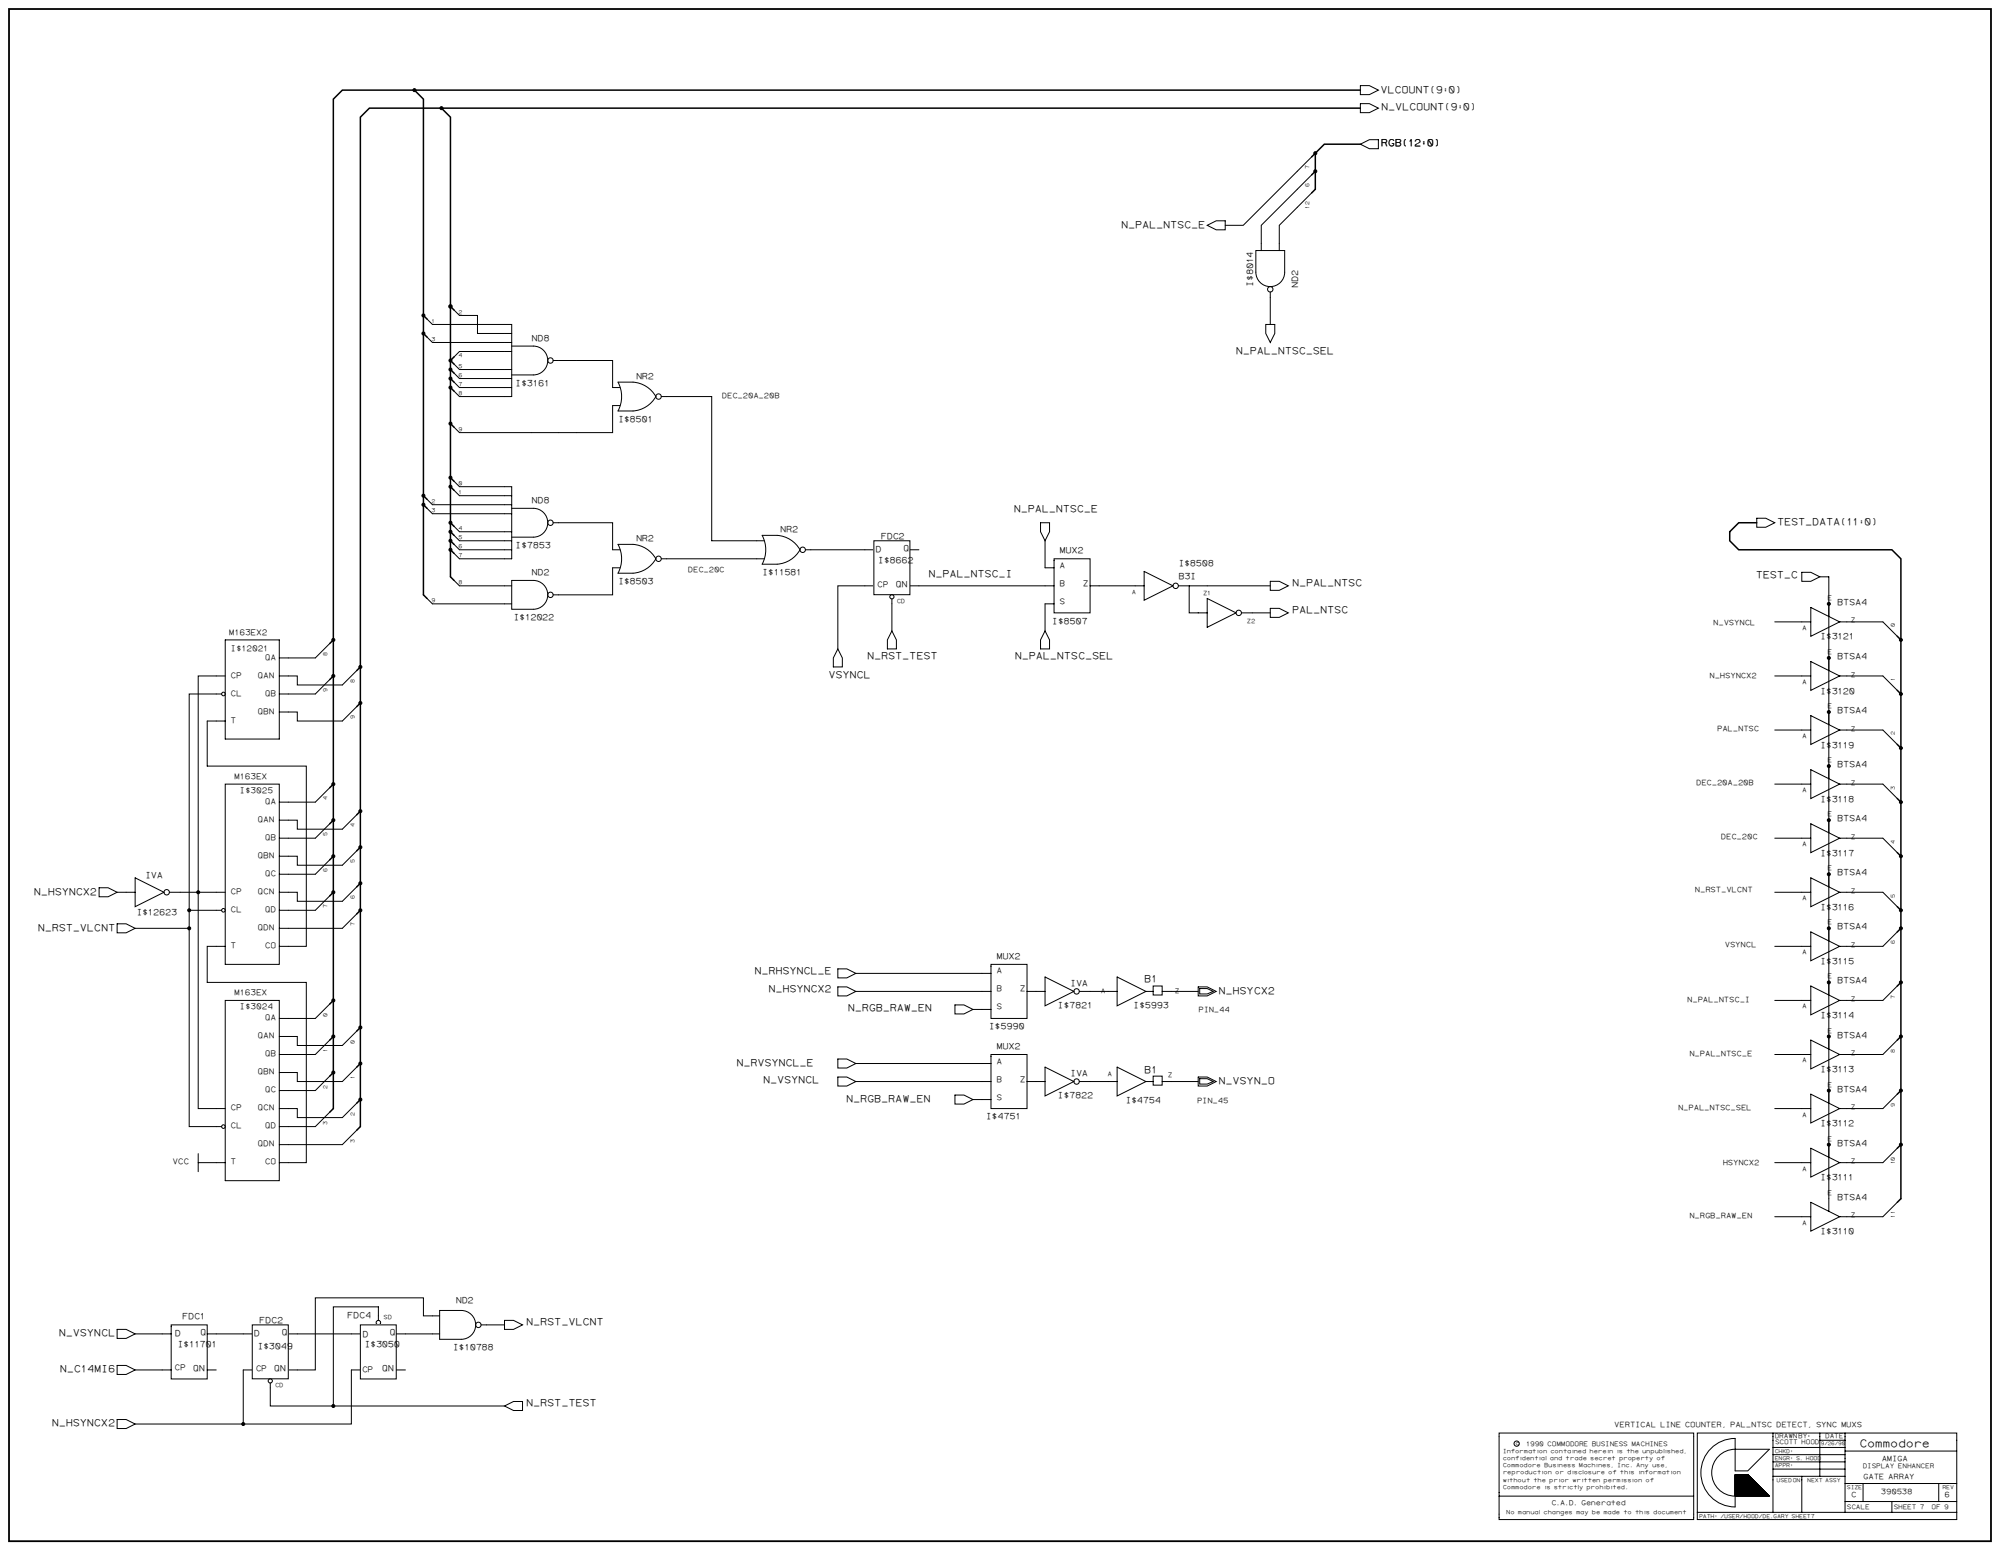
[picture p17: page 7]
N_VSYN_O; PIN_45; N_RST_TEST; N_VSYNCL; N_RVSYNCL_E; N_RGB_RAW_EN; N_PAL_NTSC_SEL; N_RST_VLCNT; N_HSYNCX2; PAL_NTSC; TEST_C; DEC_20A_20B; DEC_20C; VSYNCL; N_PAL_NTSC_I; N_PAL_NTSC_E; N_RHSYNCL_E; HSYNCX2; N_HSYCX2; PIN_44; RGB(12:0); TEST_DATA(11:0); VLCOUNT(9:0); N_VLCOUNT(9:0); N_PAL_NTSC; IVA; VCC; FDC1; FDC2; FDC4; SCALE; SHEET 7 OF 9; MUX2; BTSA4; MUX2 I$7853; QAN; QBN; QCN; QDN

VERTICAL LINE COUNTER, PAL_NTSC DETECT, SYNC MUXS

PATH: /USER/HOOD/DE.GARY SHEET7

# _G Z8 DCB

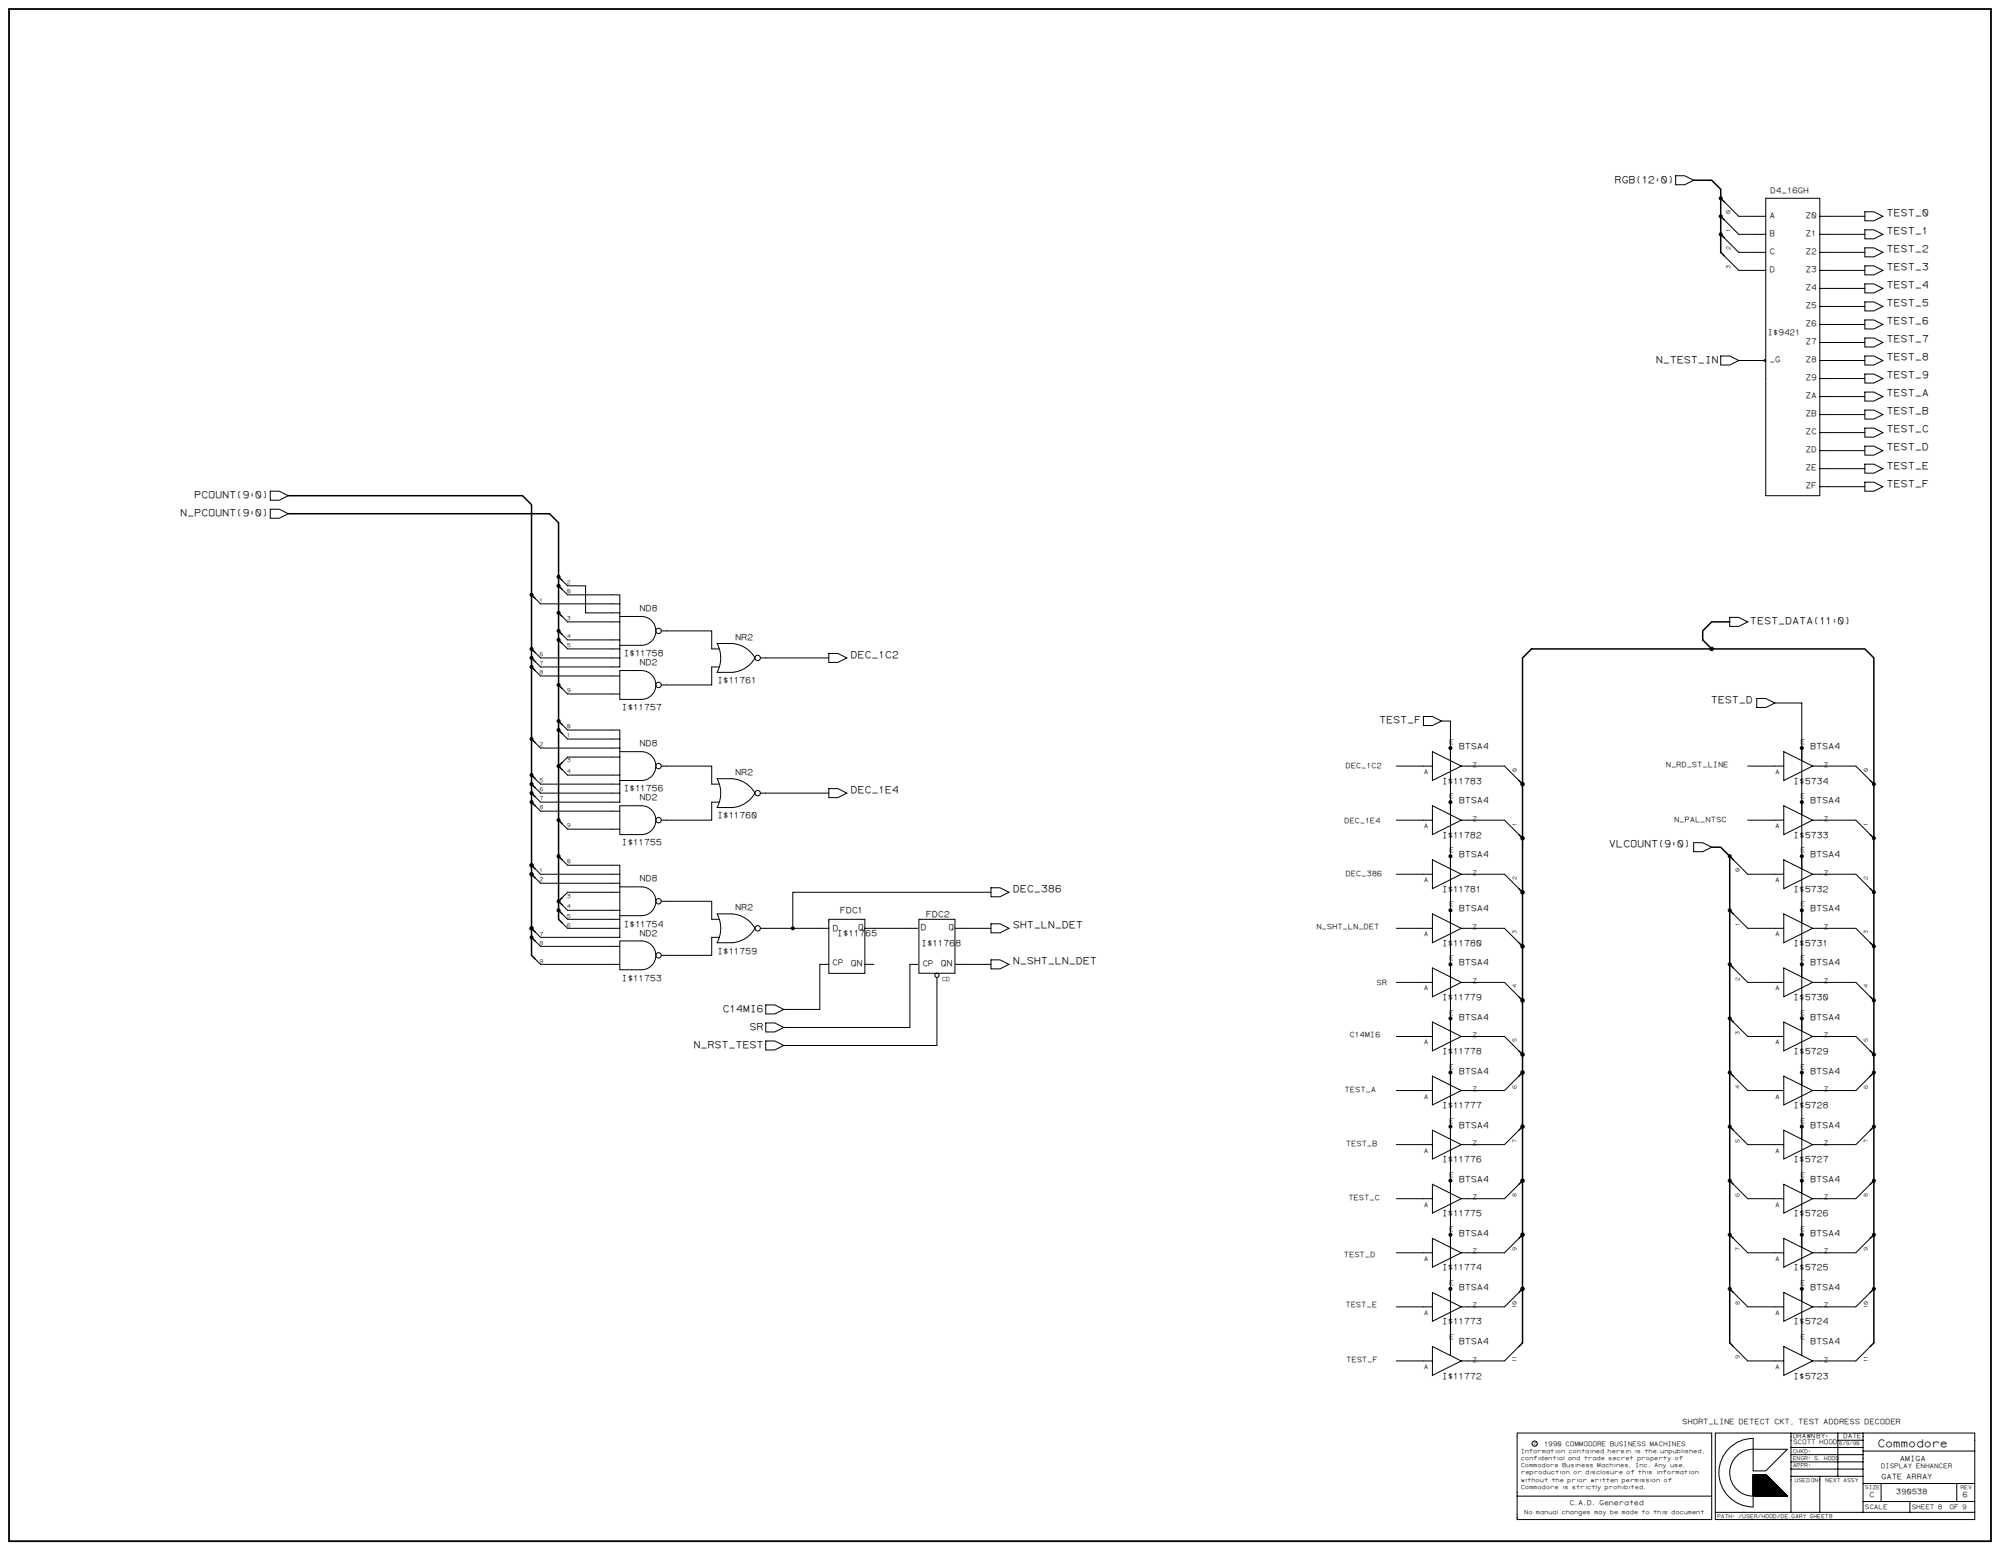
[picture p18: page 8]
N_PAL_NTSC; SHT_LN_DET; PCOUNT(9:0); TEST_D; N_PCOUNT(9:0); TEST_DATA(11:0); N_RST_TEST; N_RD_ST_LINE; TEST_0; TEST_1; TEST_2; TEST_3; TEST_5; TEST_6; TEST_7; TEST_4; TEST_9; N_TEST_IN; TEST_A; TEST_B; TEST_8; DEC_386; TEST_E; TEST_F; TEST_C; RGB(12:0); DEC_1E4; DEC_1C2; N_SHT_LN_DET; VLCOUNT(9:0); SCALE; SHEET 8 OF; BTSA4; FDC1; FDC2

SHORT_LINE DETECT CKT, TEST ADDRESS DECODER

PATH: /USER/HOOD/DE.GARY SHEET8

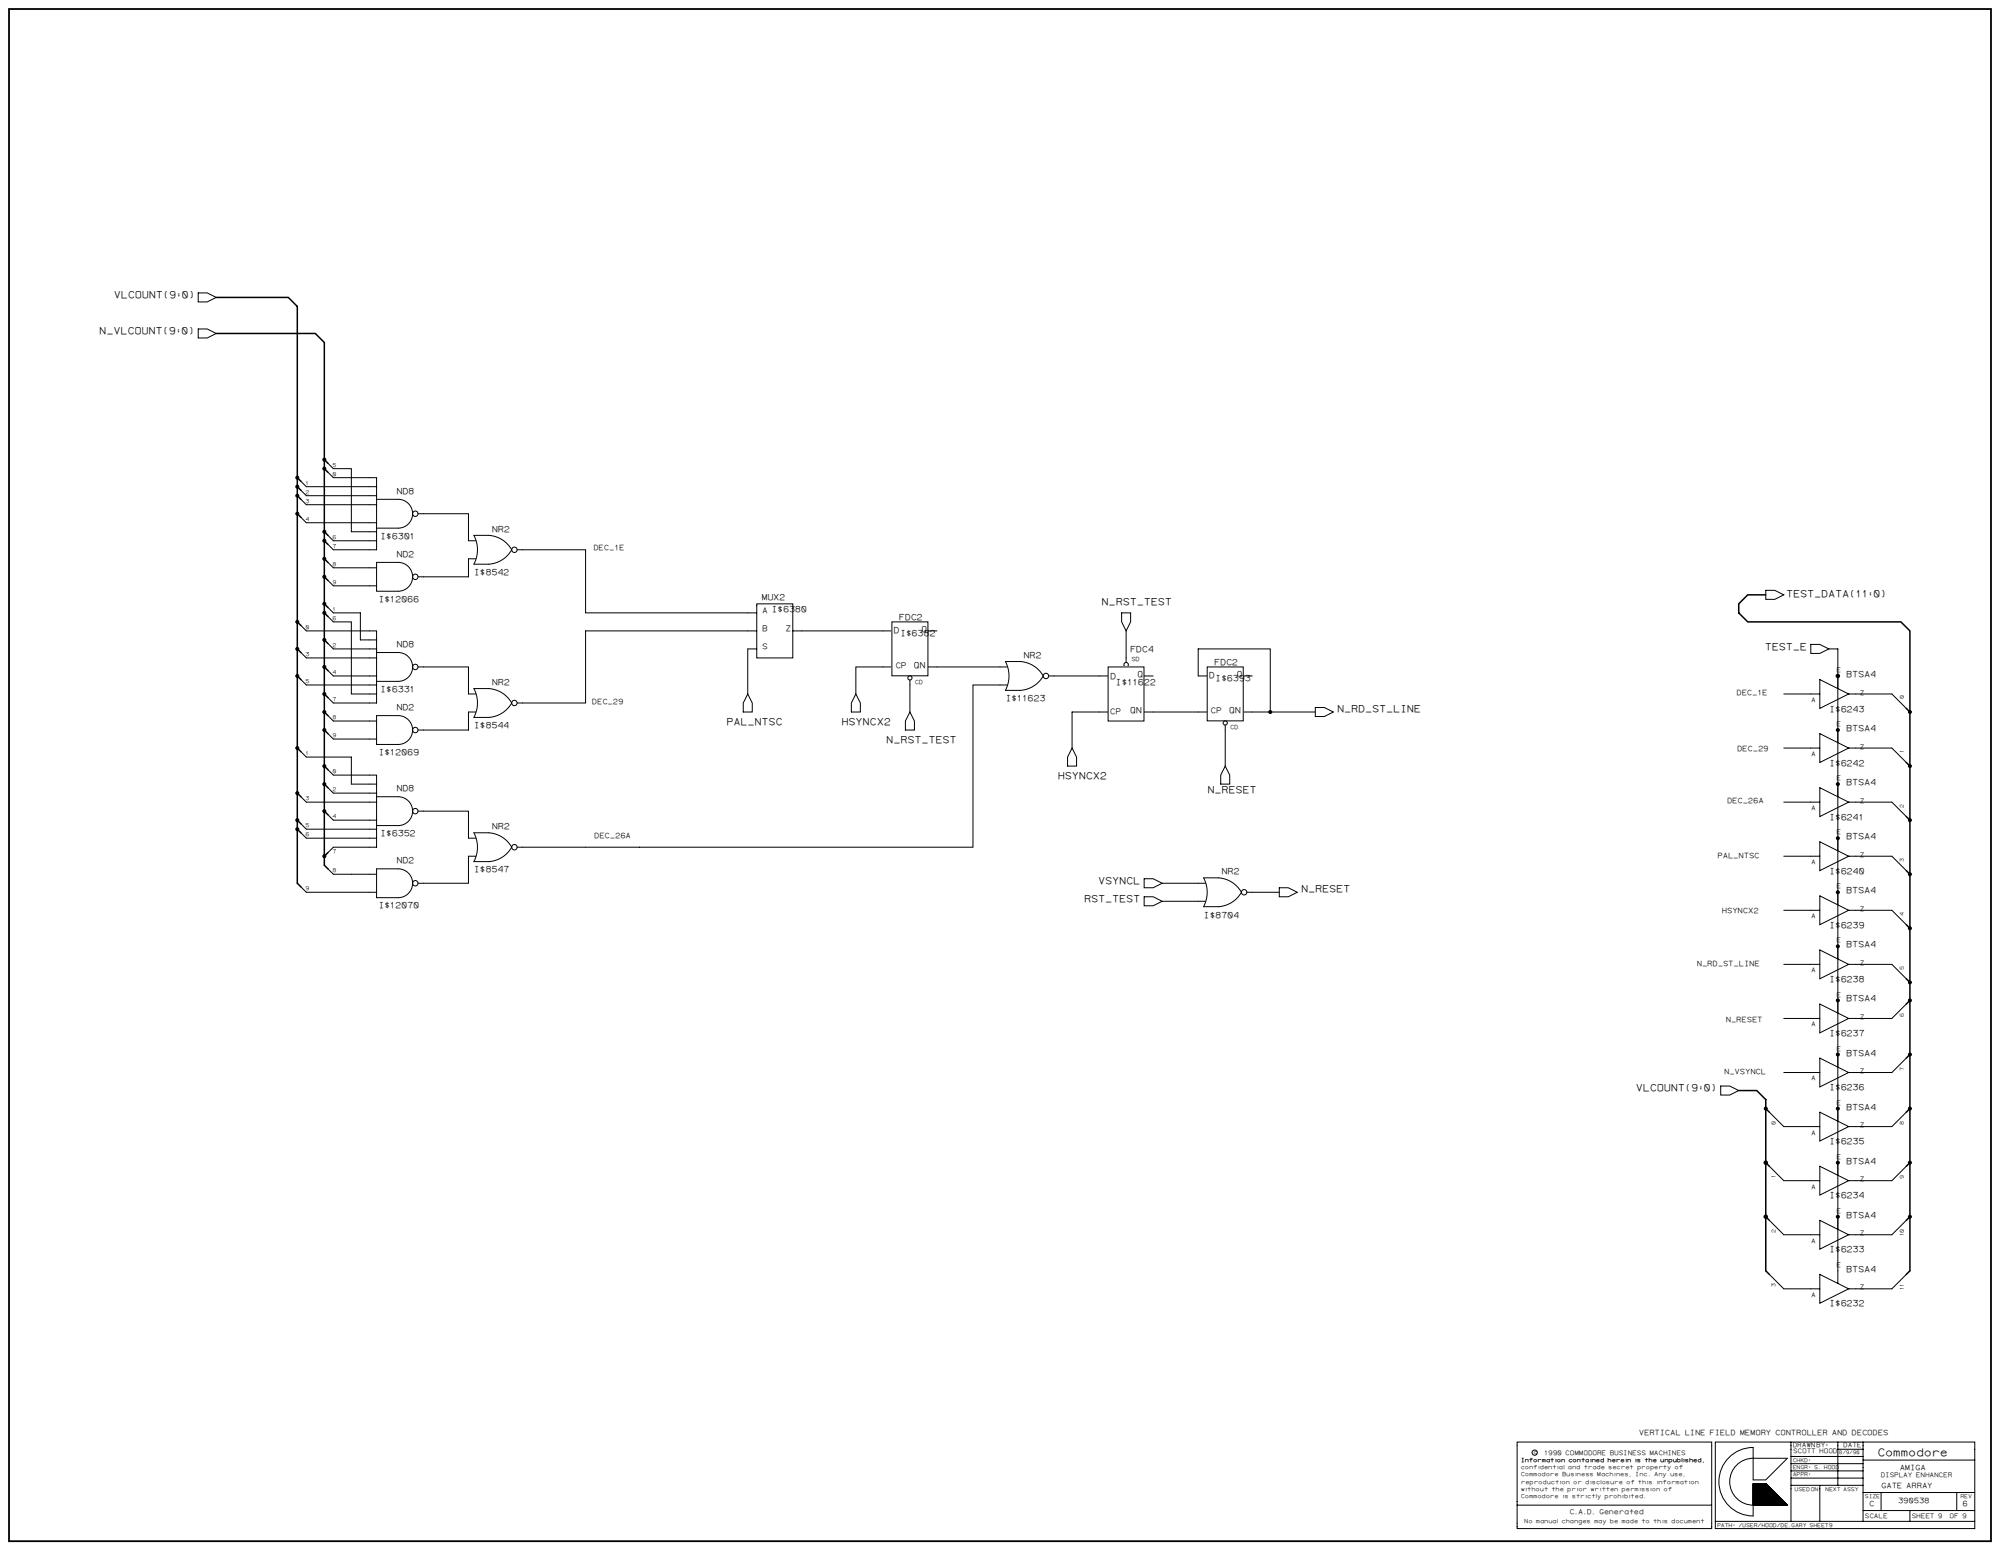
[picture p19: page 9]
TEST_E; DEC_29; DEC_26A; DEC_1E; PAL_NTSC; HSYNCX2; N_RD_ST_LINE; N_RST_TEST; N_RESET; TEST_DATA(11:0); N_VSYNCL; VLCOUNT(9:0); N_VLCOUNT(9:0); VSYNCL; RST_TEST; SCALE; SHEET 9 OF; BTSA4; FDC4; MUX2; FDC2; CPD; BAS

VERTICAL LINE FIELD MEMORY CONTROLLER AND DECODES

Information Information contained contained herein is the unpublished, unpublished,

PATH: /USER/HOOD/DE.GARY SHEET9

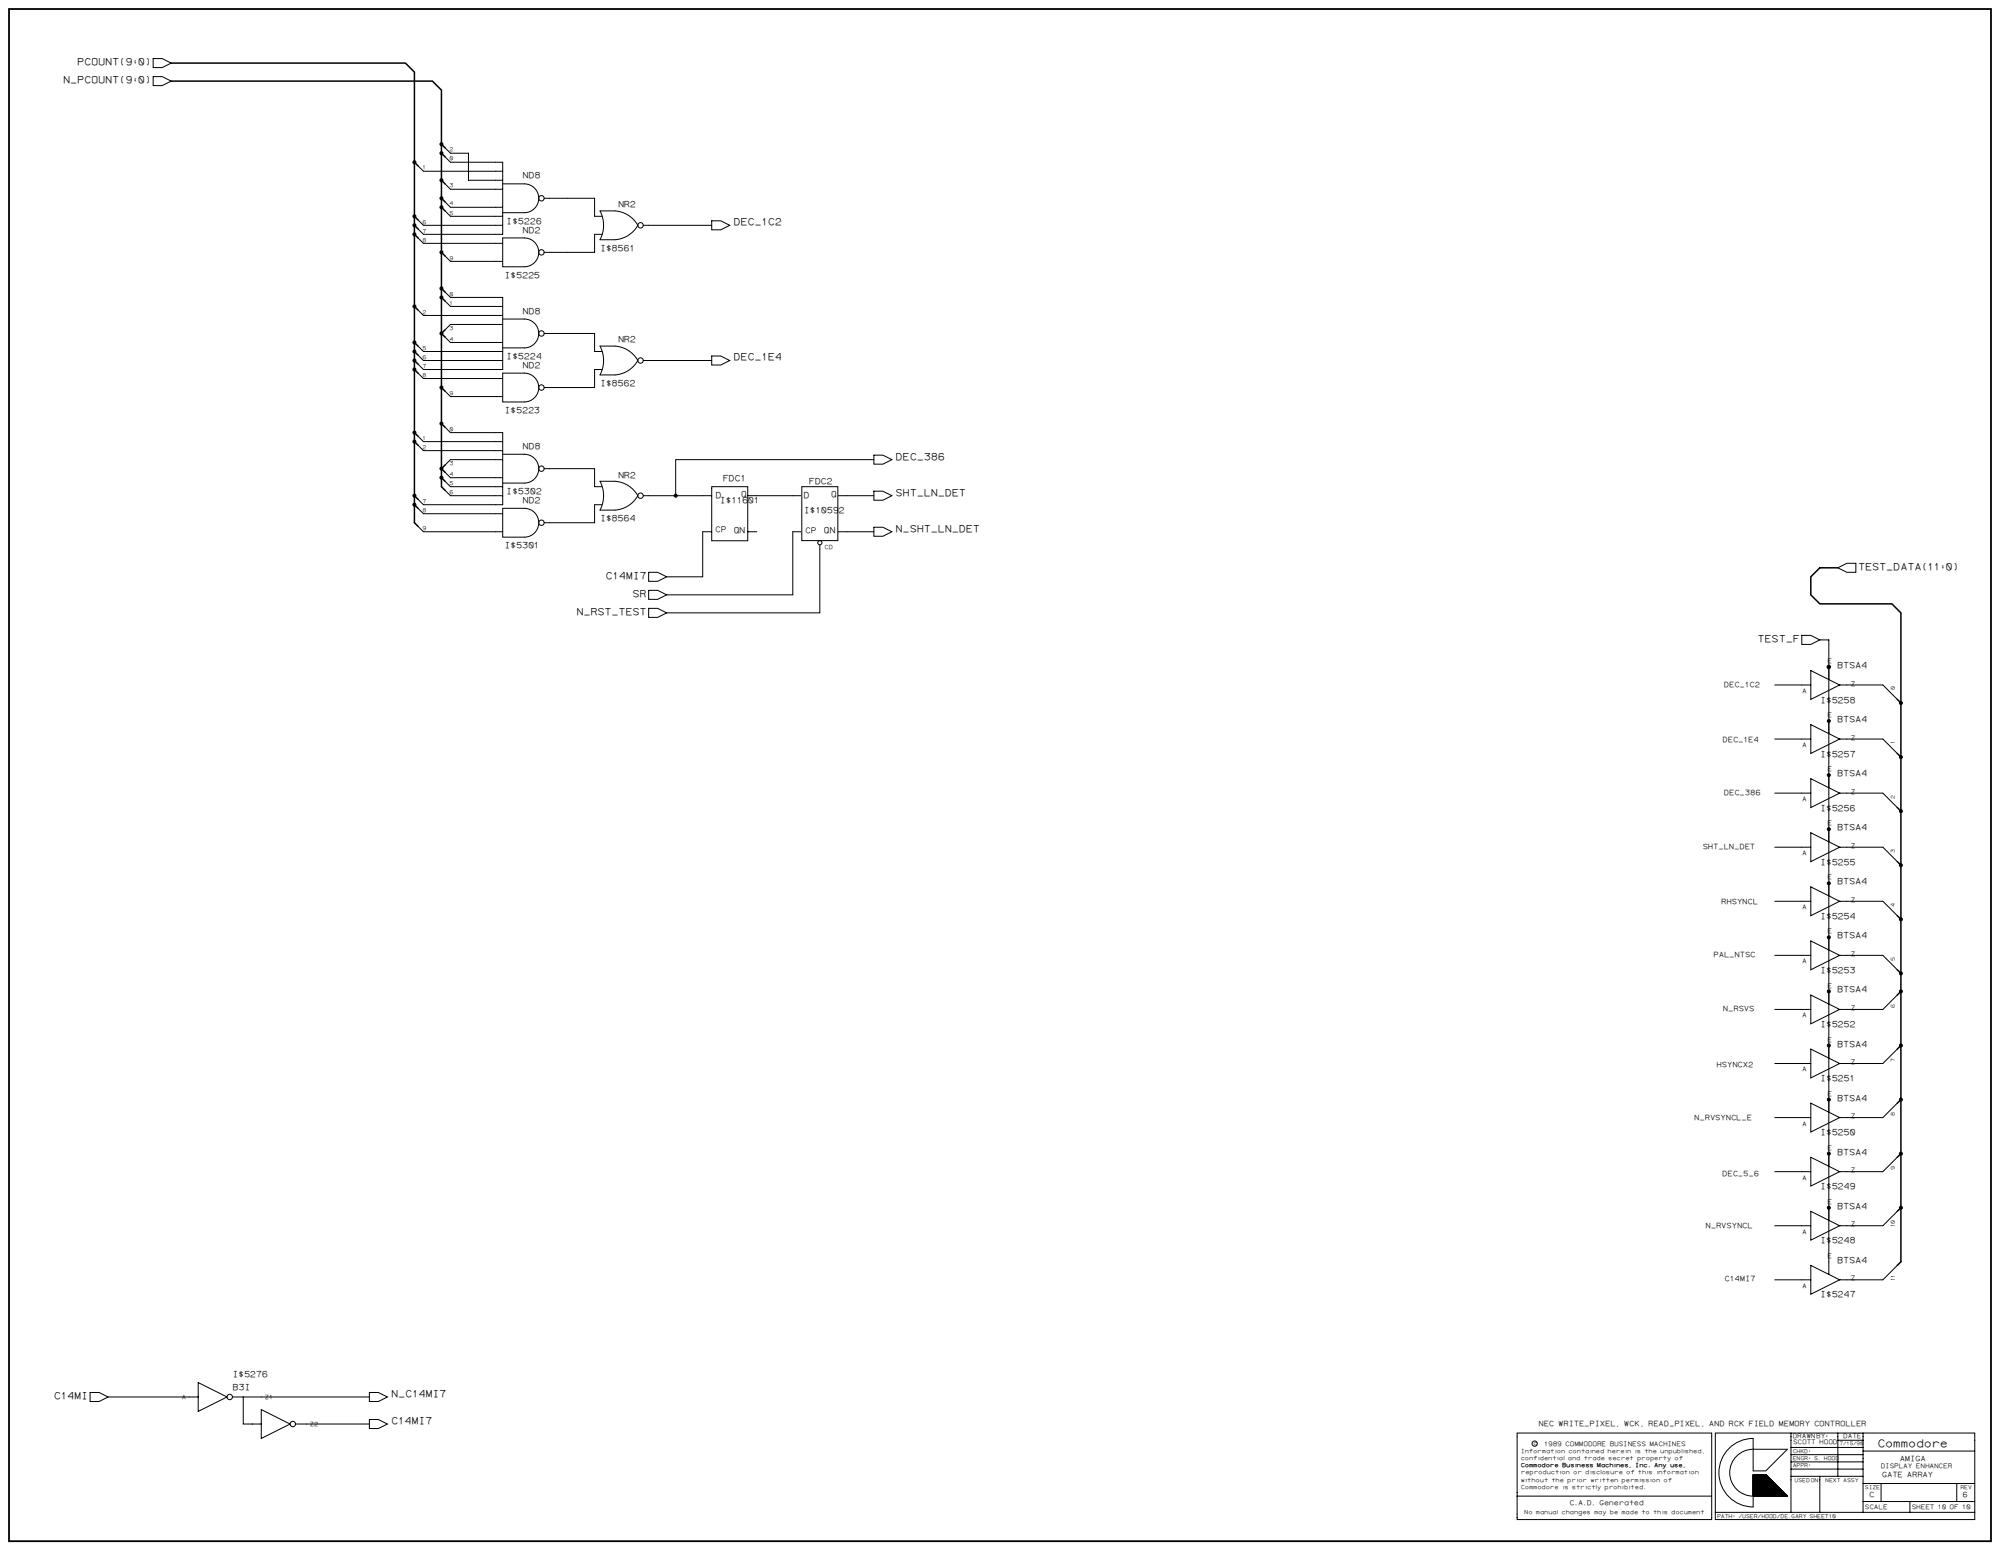
[picture p20: page 10]
DEC_1E4; DEC_1C2; SHT_LN_DET; DEC_386; N_SHT_LN_DET; N_RST_TEST; TEST_DATA(11:0); TEST_F; RHSYNCL; DEC_5_6; HSYNCX2; PAL_NTSC; N_RVSYNCL; N_RVSYNCL_E; N_RSVS; SCALE; SHEET 10 OF 10; FDC2; FDC1; BTSA4; QNQ

NEC WRITE_PIXEL, WCK, READ_PIXEL, AND RCK FIELD MEMORY CONTROLLER

1989 COMMODORE BUSINESS MACHINES

Commodore Commodore Business Business Machines, Machines, Inc. Any use,

PATH: /USER/HOOD/DE.GARY SHEET10
