reinauer/amiga_replacement_project/(list of files, drawings)

Other design files:
amiga40dip/amigaDIP40_2025-07-20.schdoc
amiga40dip/amigaDIP40_v0.7_6510_2025-07-20.pcbdoc
amiga40dip/amigaDIP40_v0.7_65816_2025-07-20.pcbdoc
amiga40dip/amigaDIP40_v0.7_cia_2025-07-20.pcbdoc
amiga40dip/amigaDIP40_v0.7_rom_27c400_2025-07-20.pcbdoc
amiga48dip/amigaDIP48_2025-07-20.schdoc
amiga48dip/amigaDIP48_v0.8_faith_2025-07-20.pcbdoc
amiga48dip/amigaDIP48_v0.8_harmonie_2025-07-20.pcbdoc
amiga48dip/amigaDIP48_v0.8_skinny_willoe_2025-07-20.pcbdoc
amiga48dip/amigaDIP48_v0.8_xander_2025-07-20.pcbdoc
