reinauer/amiga_replacement_project/(commit log)

2025-06-08 Add Amber schematics (#23)
2025-07-20 Adding all the DIP40/48 design files
    [amigaDIP40_2025-07-20.schdoc, amigaDIP40_v0.7_6510_2025-07-20.pcbdoc, amigaDIP40_v0.7_65816_2025-07-20.pcbdoc, amigaDIP40_v0.7_cia_2025-07-20.pcbdoc, amigaDIP40_v0.7_rom_27c400_2025-07-20.pcbdoc, amigaDIP48_2025-07-20.schdoc, amigaDIP48_v0.8_faith_2025-07-20.pcbdoc, amigaDIP48_v0.8_harmonie_2025-07-20.pcbdoc]
2025-09-21 Adding in mbtaylow1982's changes. (#25)
    * Fat Ramsey Internal schematics
    * moved and rename Gary_specification.pdf to FatGary folder
    * added Fat Gary schematics
    ---------
2025-12-04 Added reverse engineered schematics from 6502.org
2026-01-06 Changed RGA decode to wires
2026-01-06 Bug, only copy to shifters when armed
    [denise.v]
2026-01-10 Clarity on playfield behaviour and HAM4 (7bpl) fix
    Added comments explaining OCS/ECS undocumented behavior in single playfield mode and specified 5bpl mode to allow the 7bpl trick (aka HAM4).
    [denise.v]
2026-01-10 Fixup for typical merge error
    [denise.v]
2026-01-29 Added good Amiga 1000 schematics (reference)
2026-01-29 Switch to makefile
